ROBOTIS-GIT/ROBOTIS-OP-Series-Data/README.md

# ROBOTIS-OP-Series-Data
ROBOTIS-OP series datas
