ROBOTIS-GIT/ROBOTIS-OP-Series-Data/ROBOTIS-OP, ROBOTIS-OP2/Hardware/Electronics/Sub Controller/DARwIn-OP_Subcontroller_Schematics.pdf

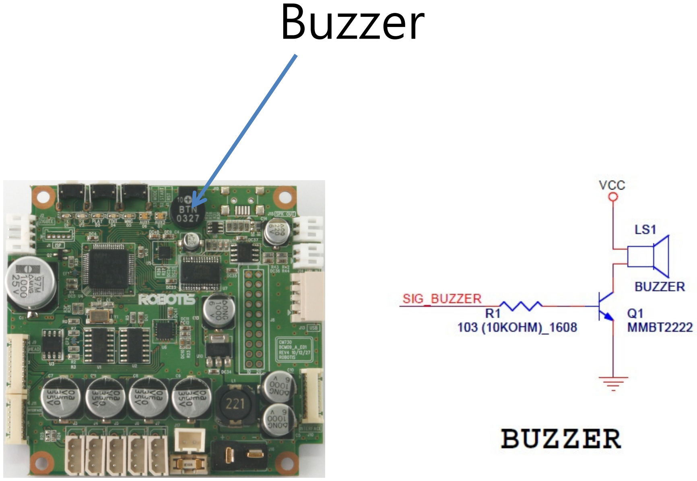
[picture p2: figure]
Buzzer
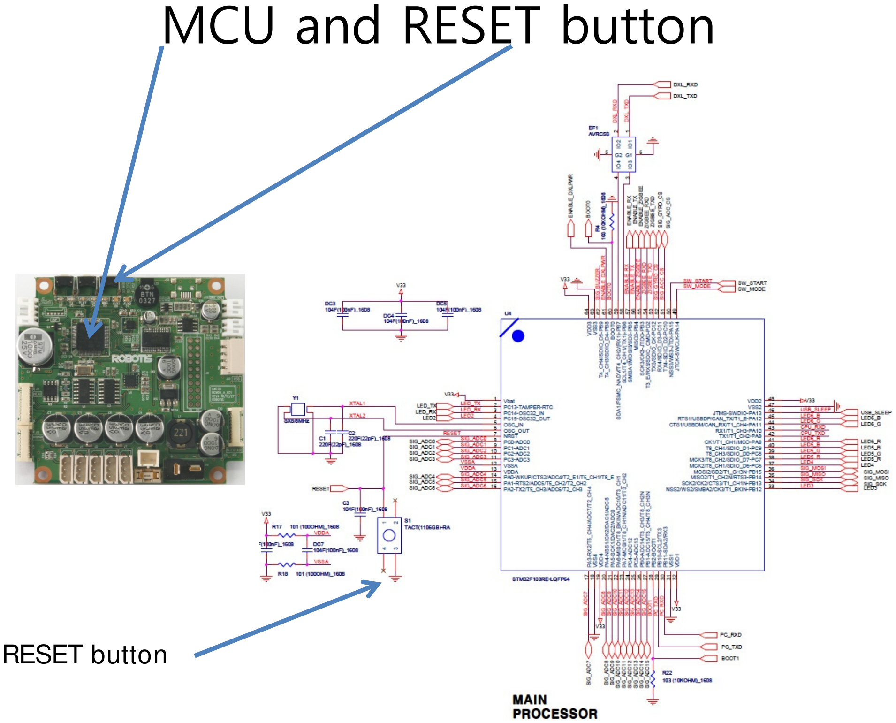
[picture p3: page 2]

MCU and RESET button

RESET button

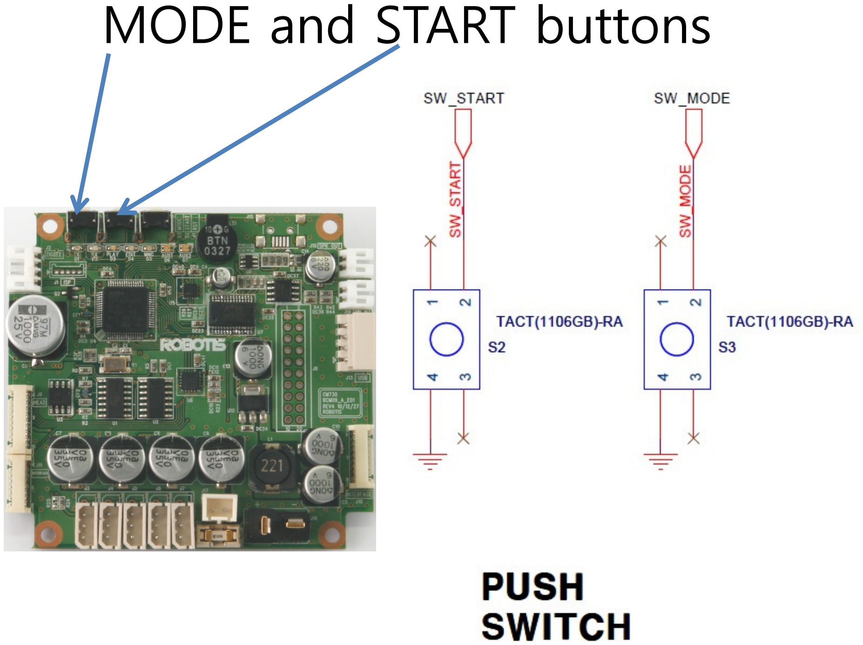
[picture p4: page 3]

MODE and START buttons

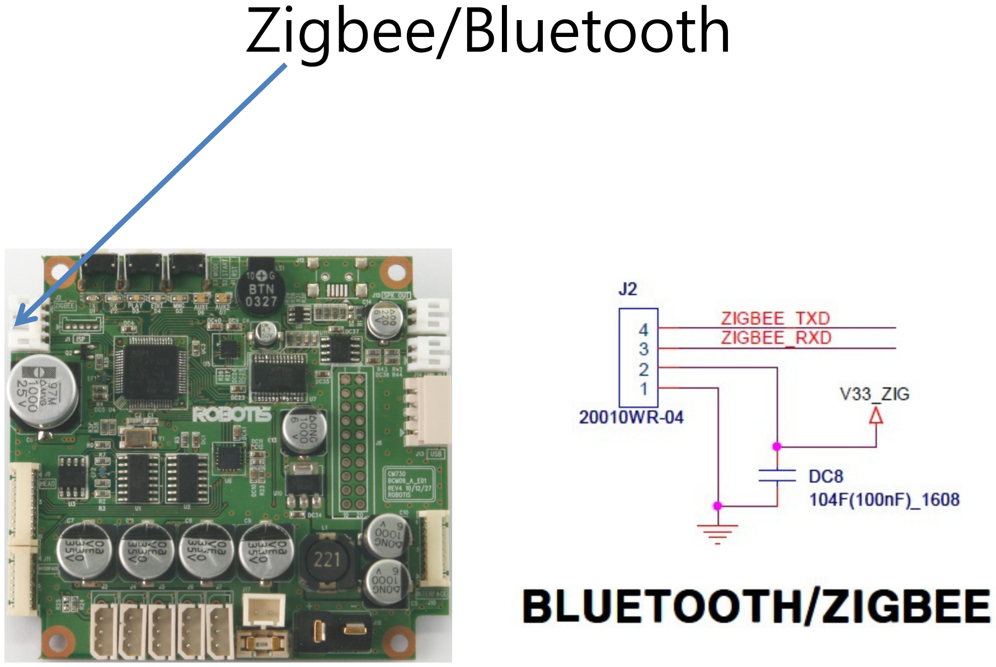
[picture p5: figure]
Zigbee/Bluetooth
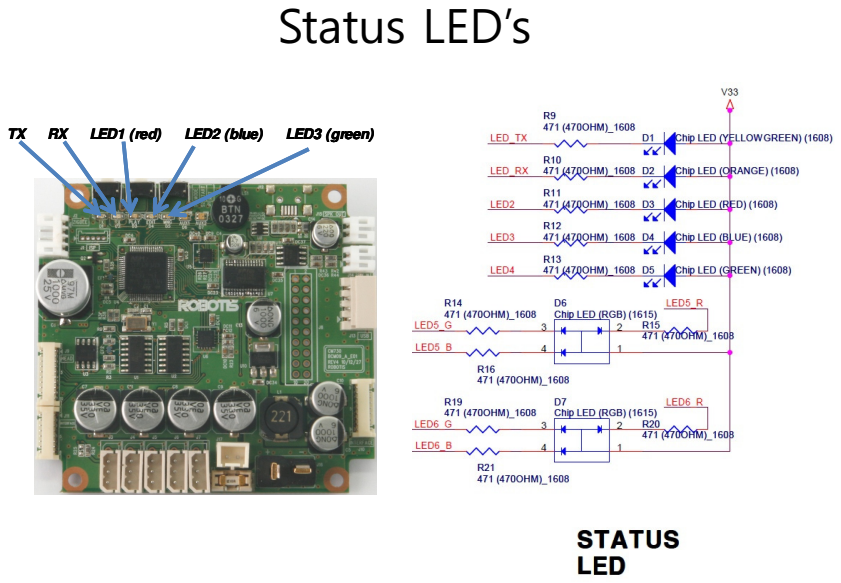
[picture p6: page 5]
Status LED’s; LED1 (red); LED2 (blue); LED3 (green)

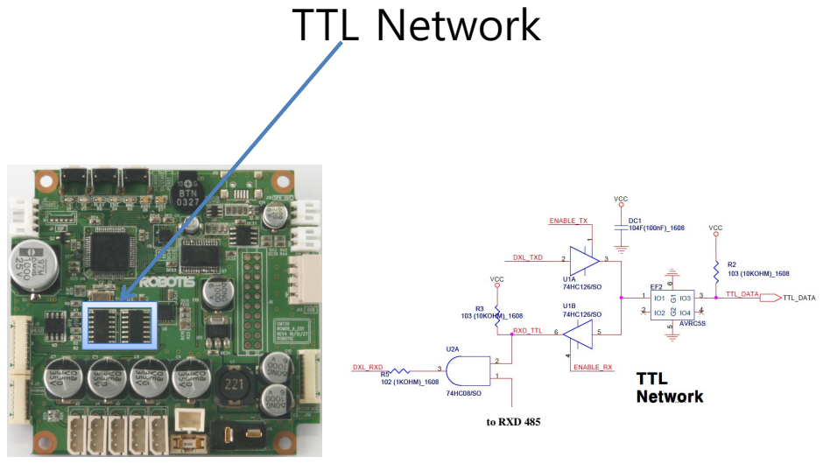
[picture p7: page 6]
TTL Network; to RXD 485

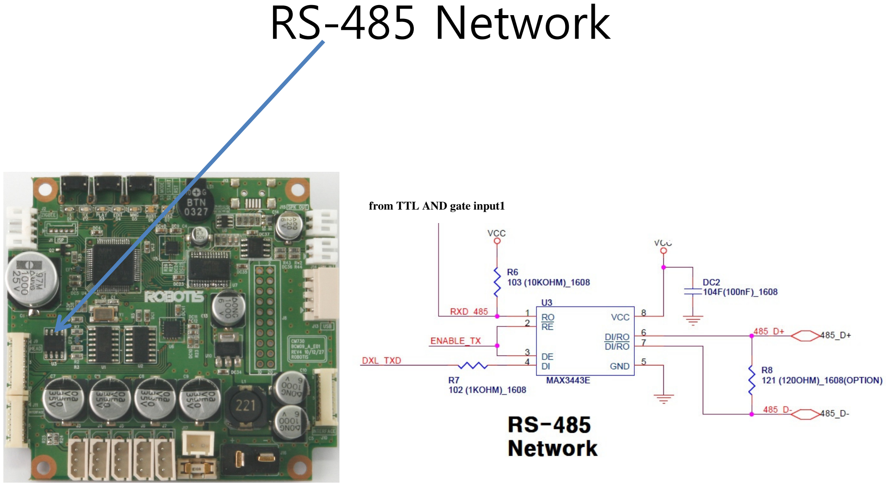
[picture p8: figure]
RS-485 Network; from TTL AND gate input1
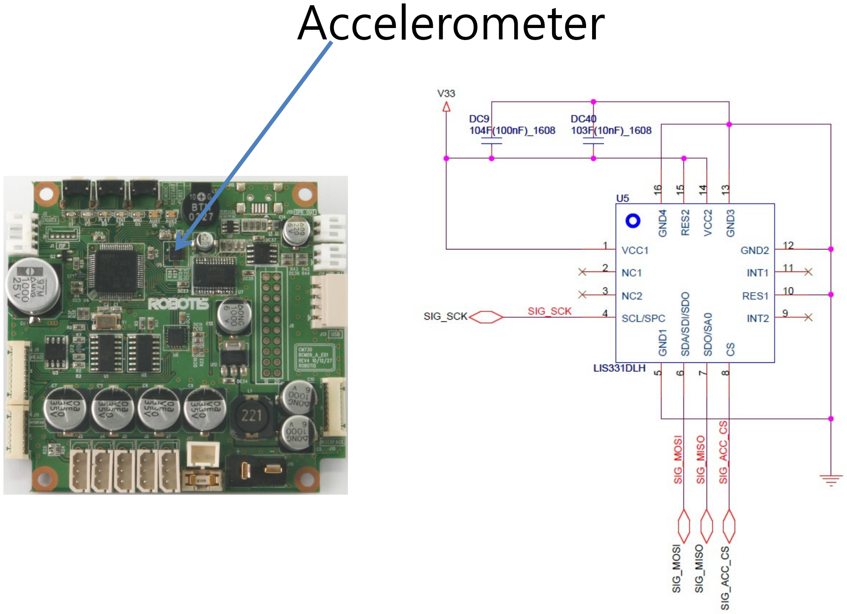
[picture p9: page 8]

Accelerometer

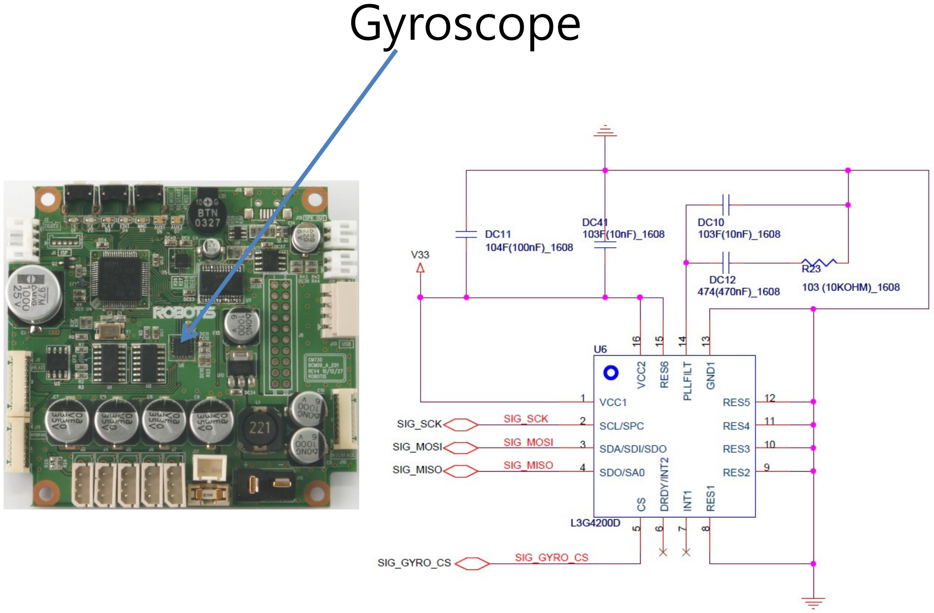
[picture p10: page 9]

Gyroscope

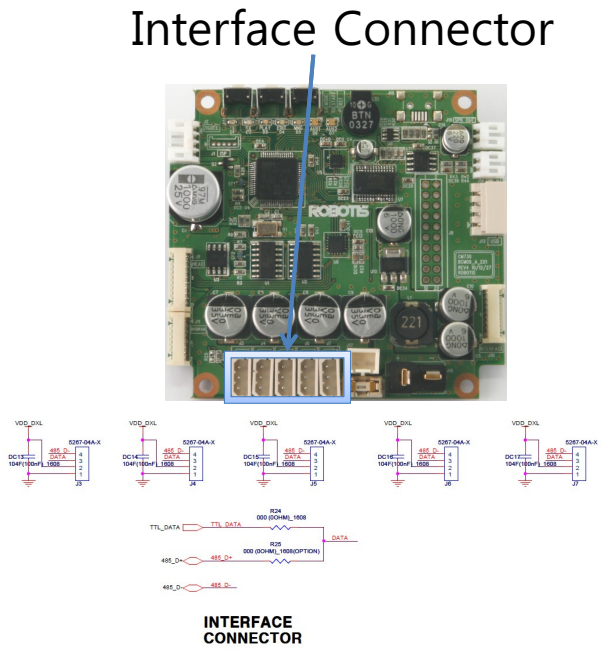
[picture p11: page 10]
Interface Connector

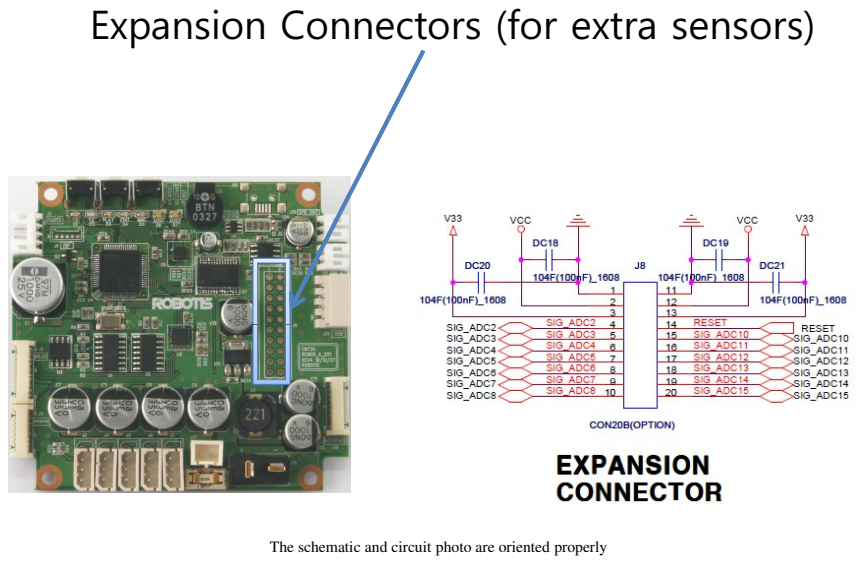
[picture p12: page 11]

Expansion Connectors (for extra sensors)

The schematic and circuit photo are oriented properly

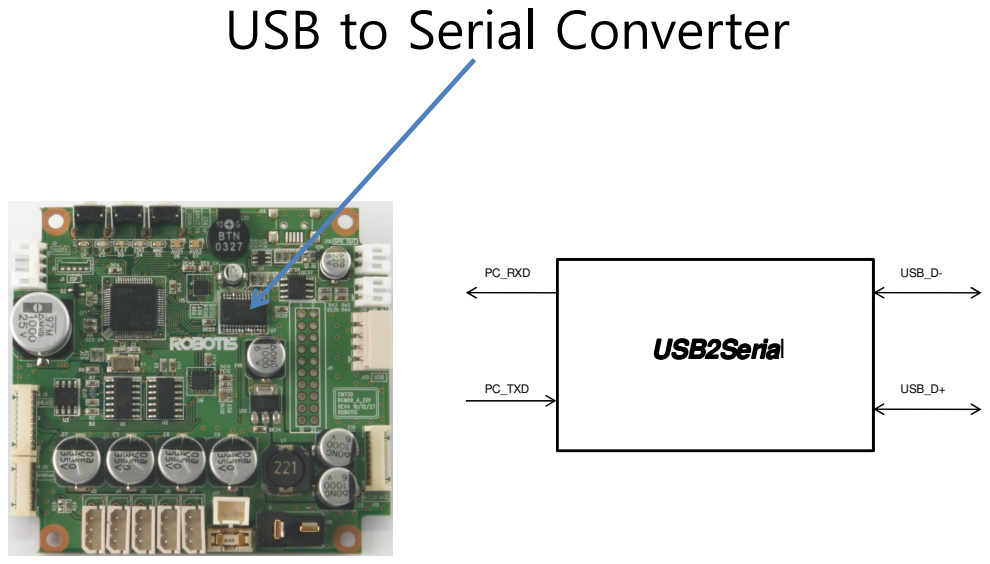
[picture p13: page 12]
USB2Serial; PC_RXD; USB_D-; PC_TXD; USB_D+

USB to Serial Converter

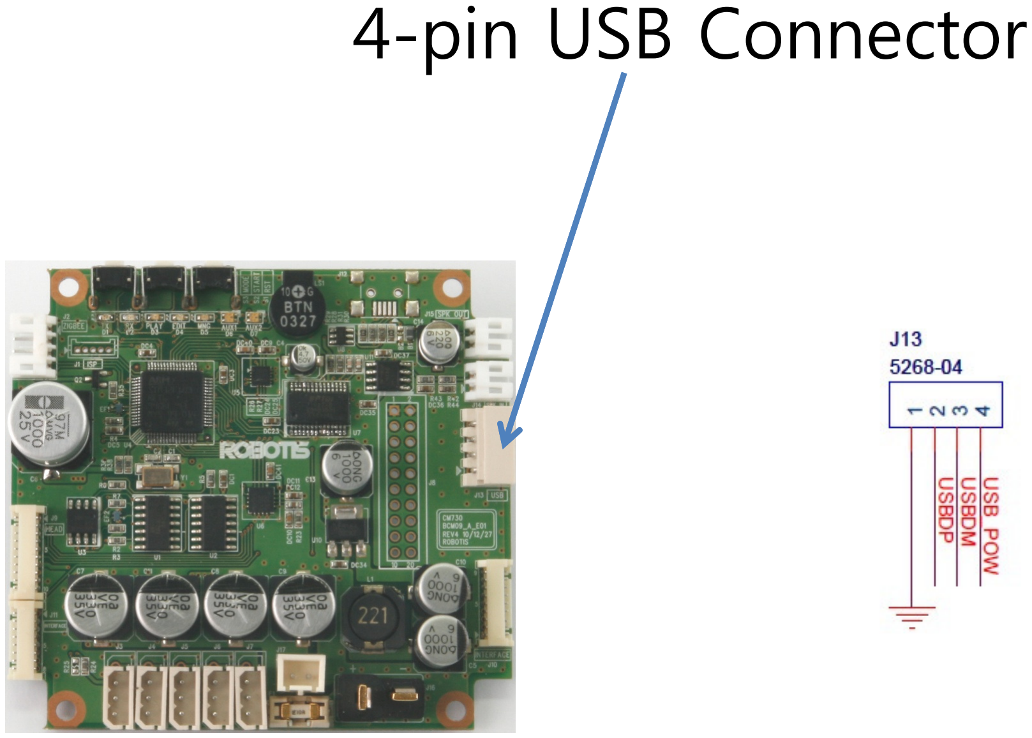
[picture p14: figure]
4-pin USB Connector
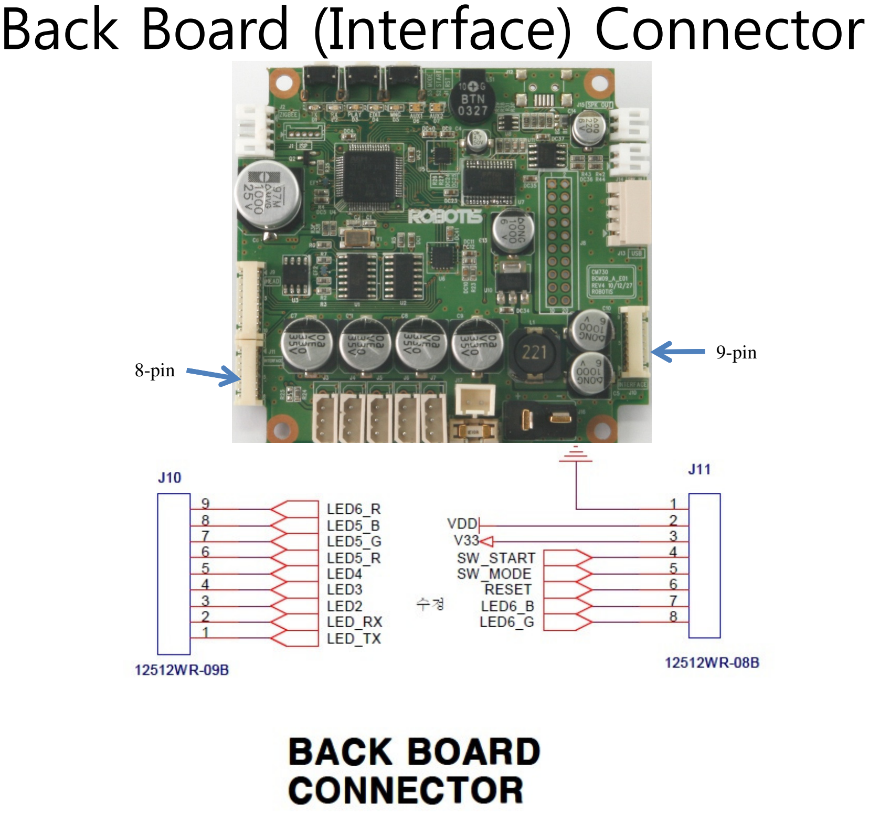
[picture p15: page 14]

Back Board (Interface) Connector

8-pin

9-pin

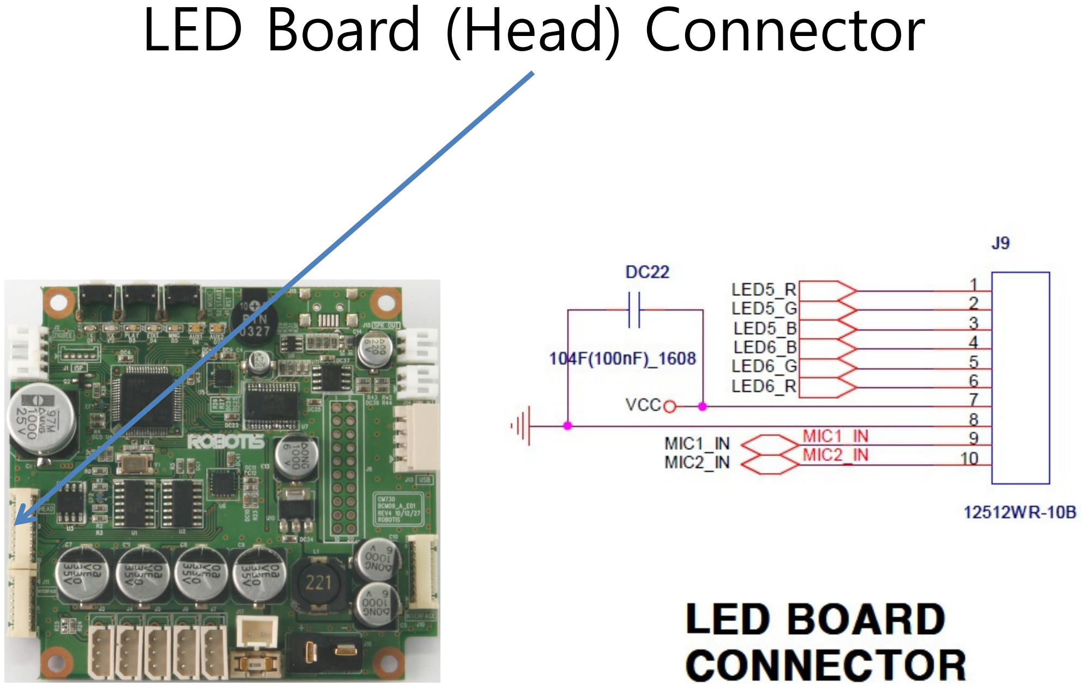
[picture p16: page 15]

LED Board (Head) Connector

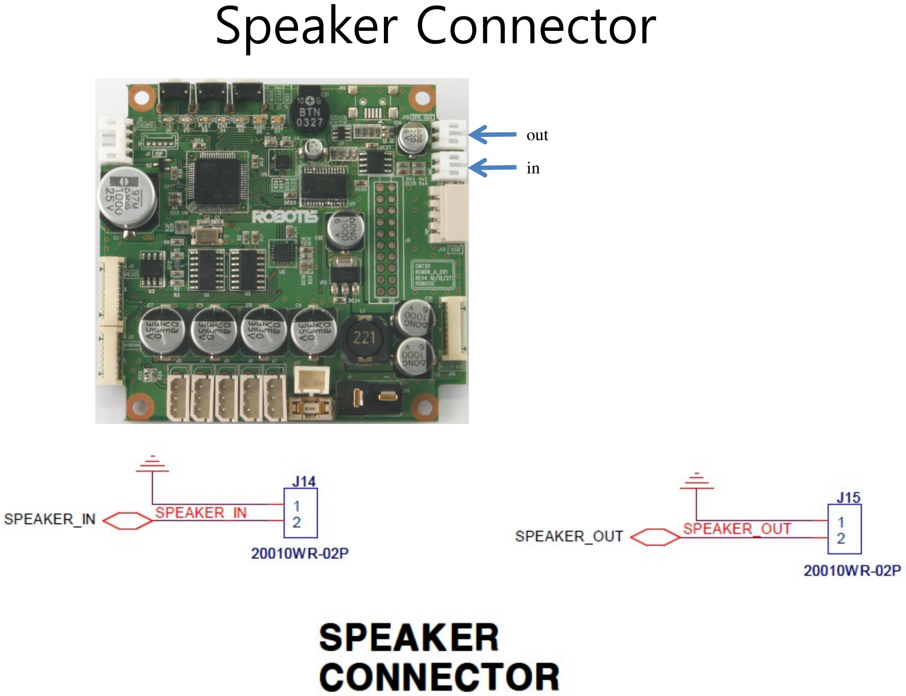
[picture p17: page 16]

Speaker Connector

in

out

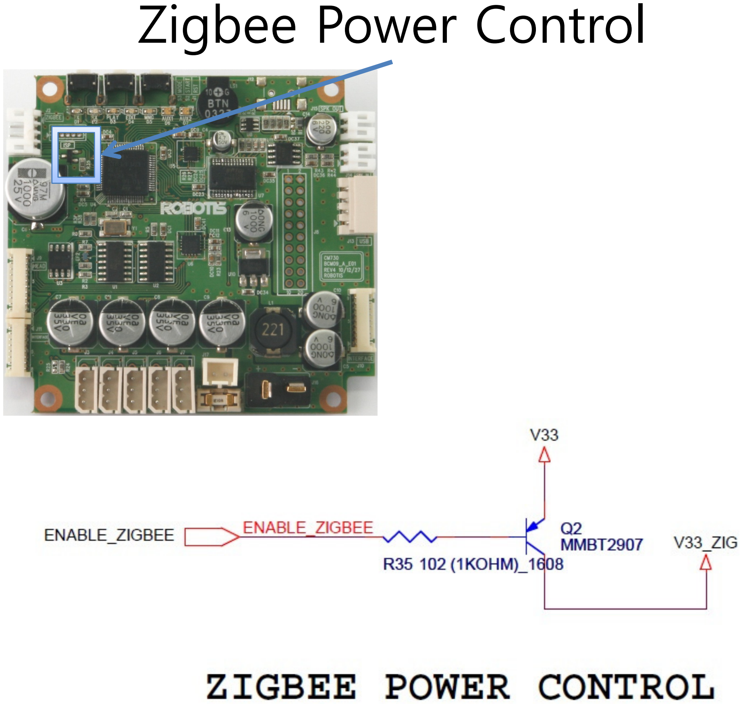
[picture p18: figure]
Zigbee Power Control

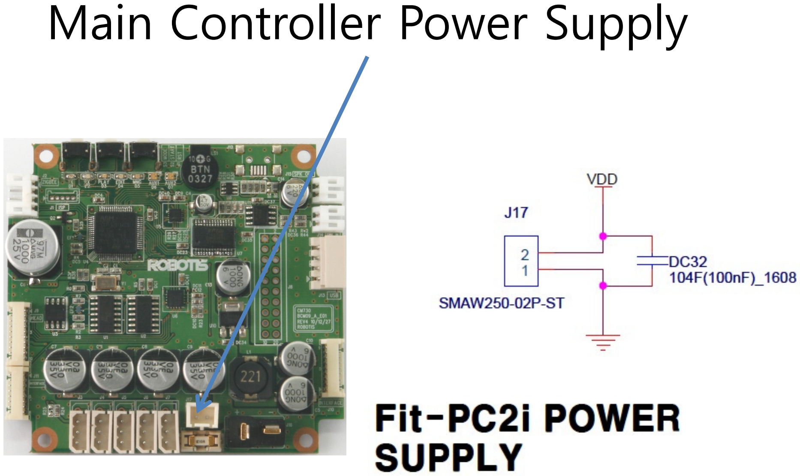
[picture p19: figure]
Main Controller Power Supply

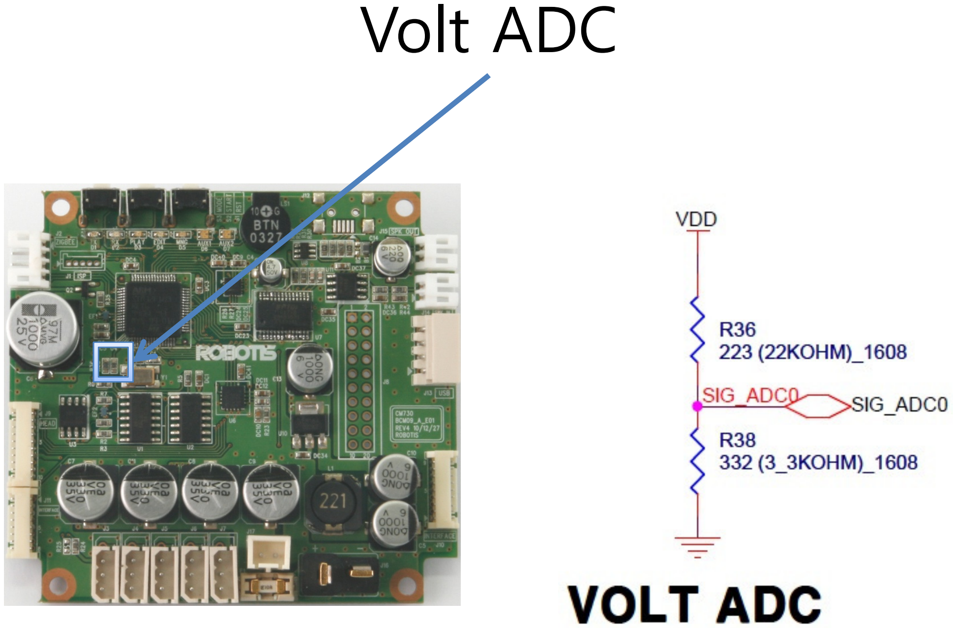
[picture p20: figure]
Volt ADC

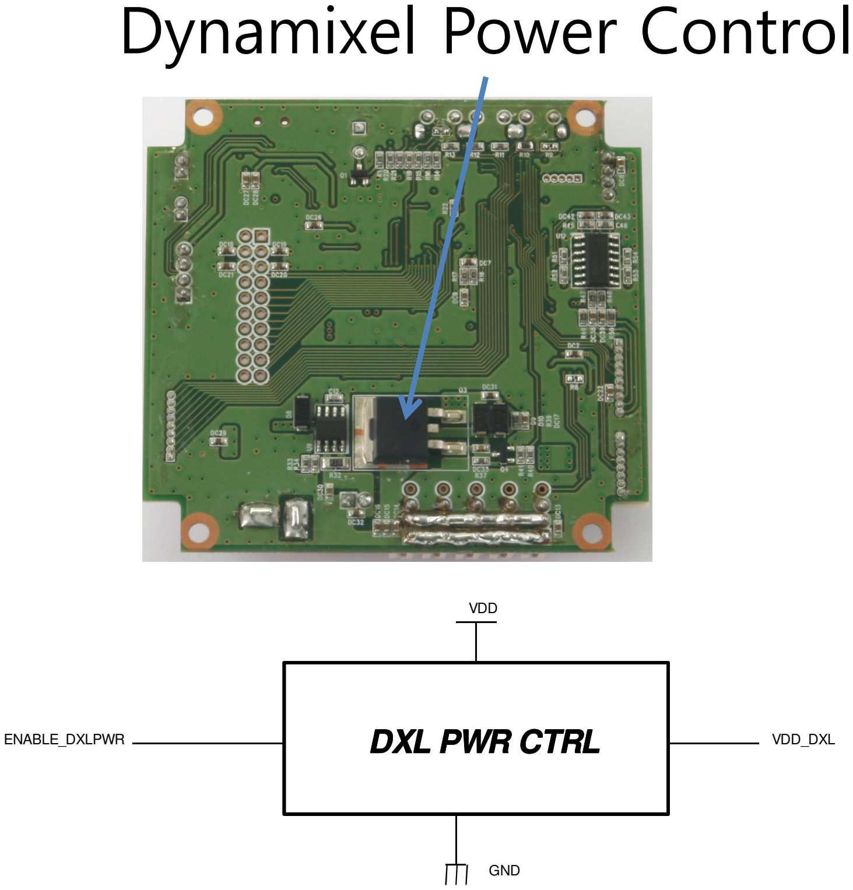
[picture p21: figure]
Dynamixel Power Control; DXL PWR CTRL; VDD; GND; ENABLE_DXLPWR; VDD_DXL

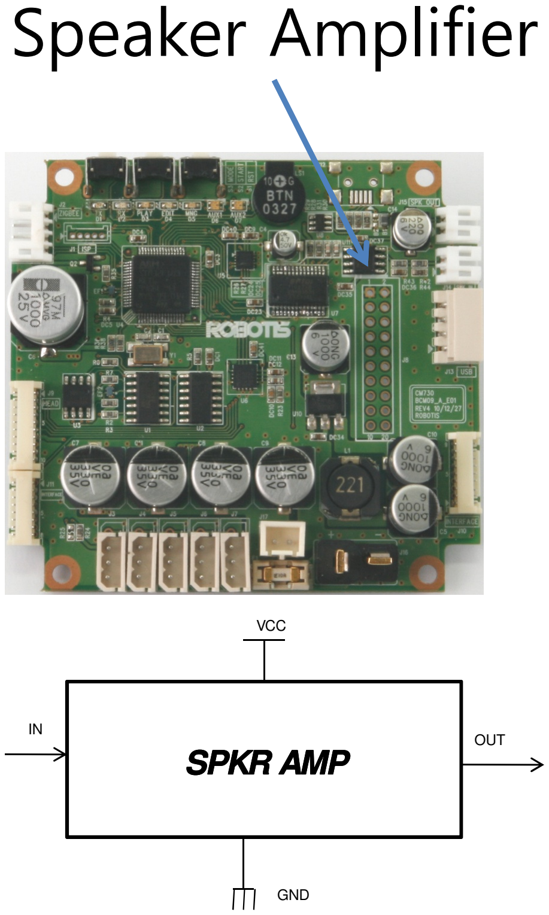
[picture p22: figure]
Speaker Amplifier; SPKR AMP; VCC; GND; OUT
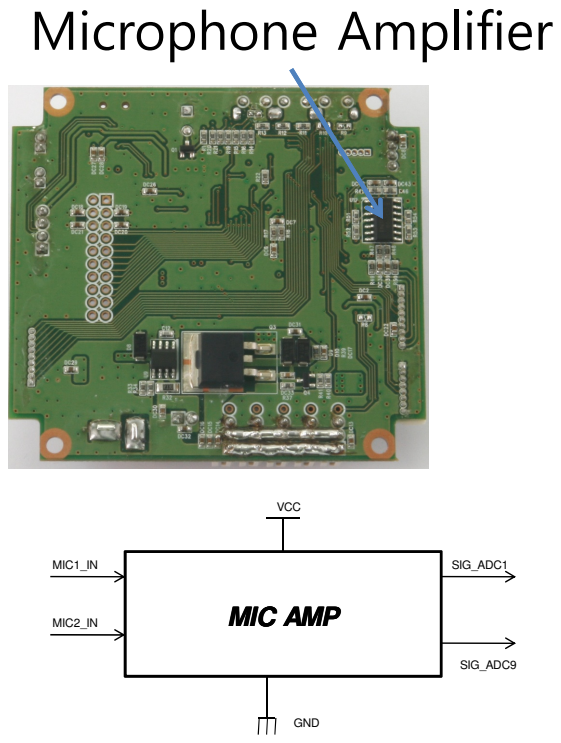
[picture p23: page 22]
Microphone Amplifier; MIC AMP; VCC; GND; MIC1_IN; SIG_ADC9; SIG_ADC1; MIC2_IN
