ROBOTIS-GIT/ROBOTIS-OP-Series-Data/ROBOTIS-OP3/Hardware/Mechanics/Skin/ROBOTIS-OP3-Skin_OP2-Style/README.md

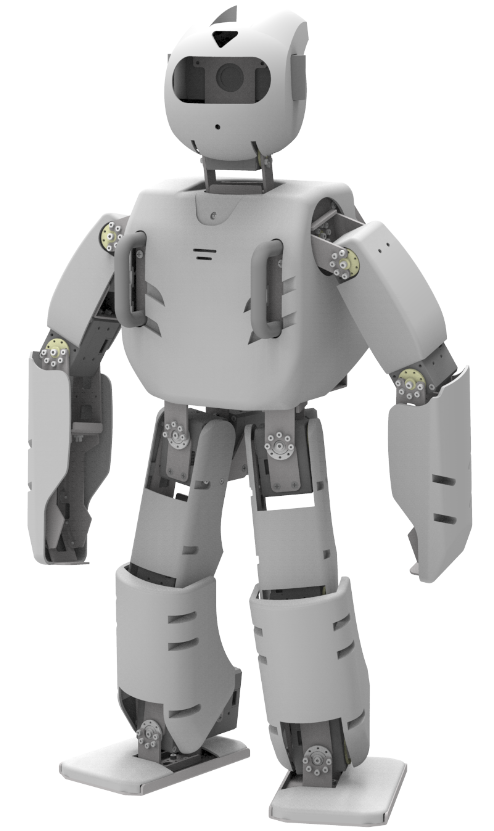
[picture p24: ROBOTIS-OP3/Hardware/Mechanics/Skin/ROBOTIS-OP3-Skin_OP2-Style/ROBOTIS-OP3-Skin_OP2-Style.png]
