ROBOTIS-GIT/ROBOTIS-OP-Series-Data/ROBOTIS-OP3/Hardware/Mechanics/Skin/ROBOTIS-OP3-Skin_Ver1/README.md

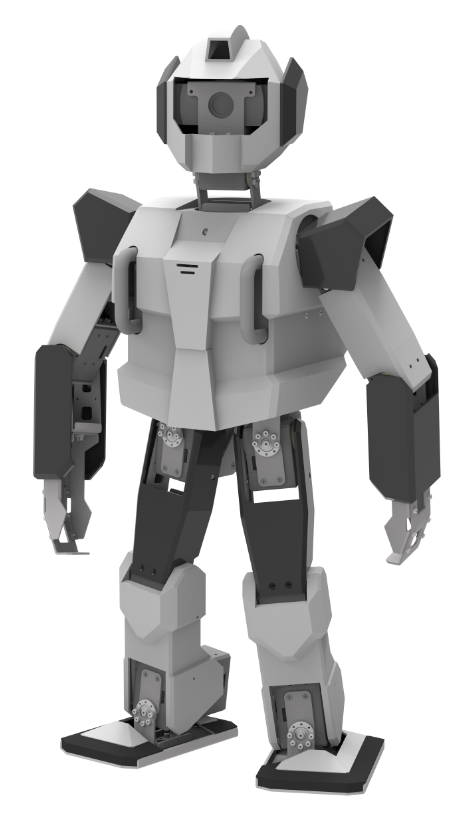
[picture p25: ROBOTIS-OP3/Hardware/Mechanics/Skin/ROBOTIS-OP3-Skin_Ver1/ROBOTIS_OP3-Skin_Ver1.png]
