ROBOTIS-GIT/ROBOTIS-OP-Series-Data/ROBOTIS-OP3/Hardware/Mechanics/Skin/ROBOTIS-OP3-Skin_THORMANG3-Style/README.md

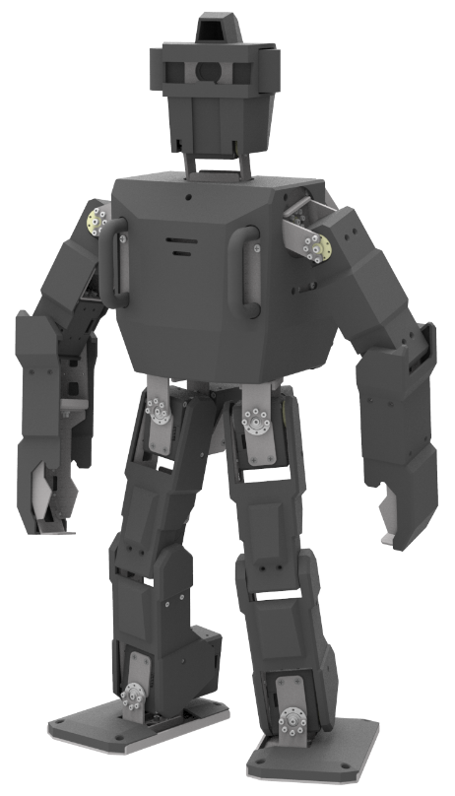
[picture p26: ROBOTIS-OP3/Hardware/Mechanics/Skin/ROBOTIS-OP3-Skin_THORMANG3-Style/ROBOTIS-OP3-Skin_THORMANG3-Style.png]
