ROBOTIS-GIT/ROBOTIS-OP-Series-Data/ROBOTIS-OP, ROBOTIS-OP2/Hardware/Mechanics/DARwIn-OP_Actuator ID.pdf

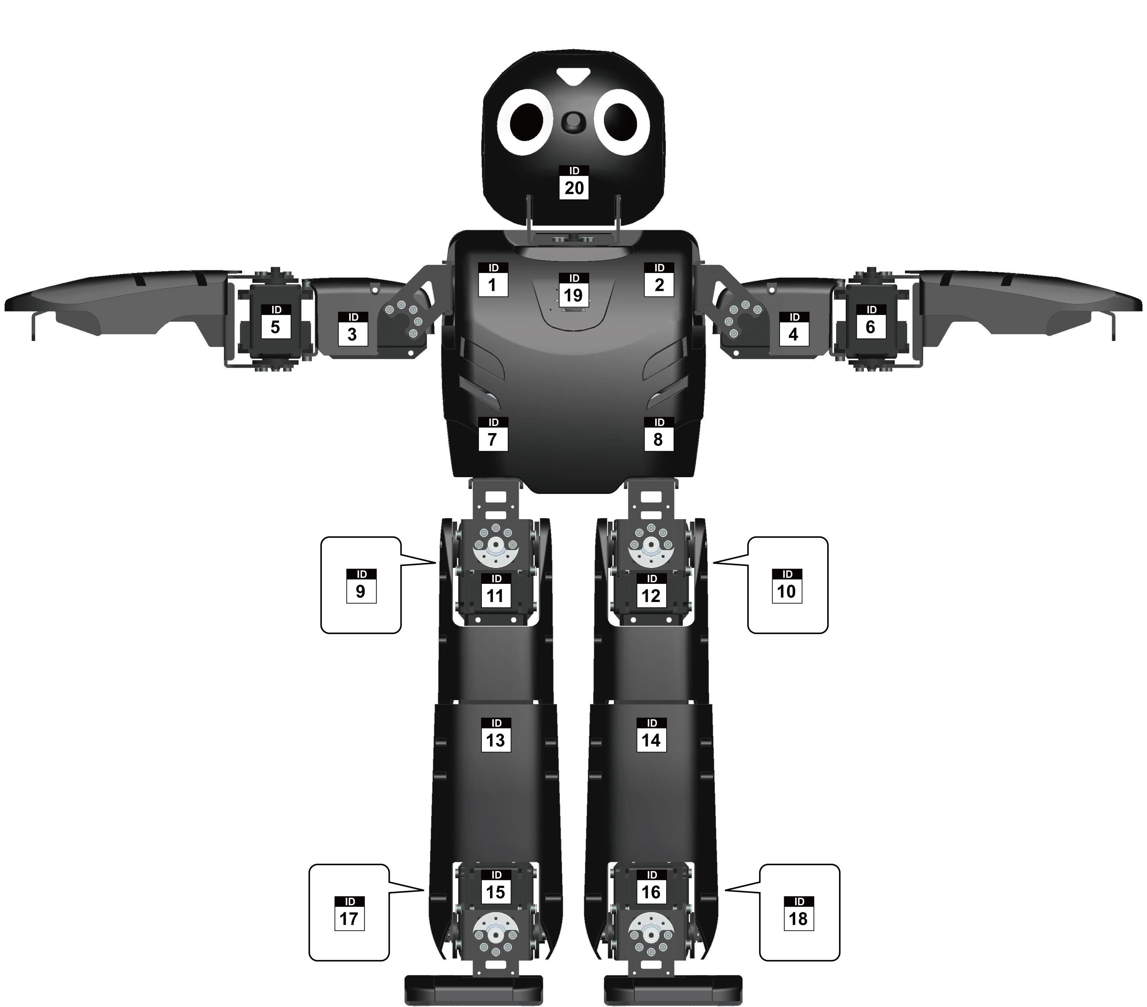
[picture p27: figure]
