ROBOTIS-GIT/ROBOTIS-OP-Series-Data/ROBOTIS-OP, ROBOTIS-OP2/Hardware/Mechanics/DARwIn-OP_Dimension.pdf

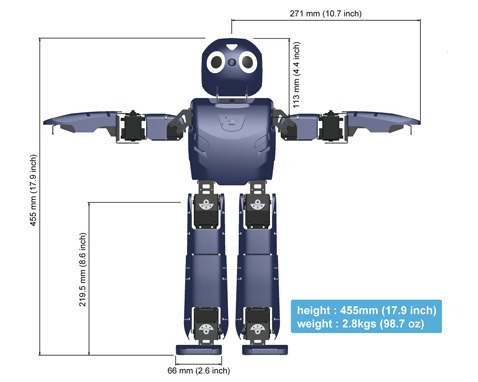
[picture p28: figure]
