ROBOTIS-GIT/ROBOTIS-OP-Series-Data/ROBOTIS-OP, ROBOTIS-OP2/Hardware/Mechanics/DARwIn-OP_Kinematics.pdf

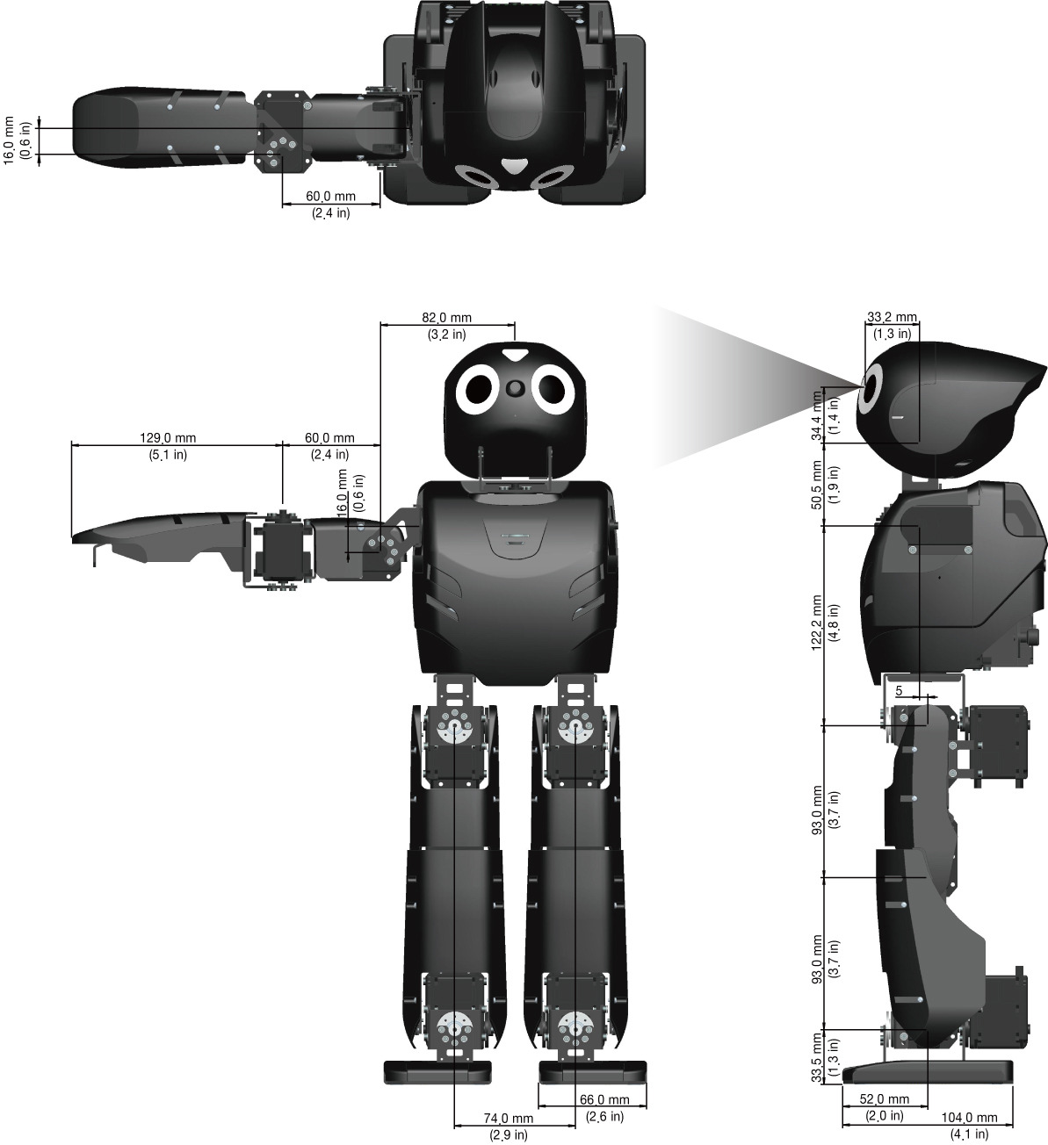
[picture p29: page 1]
