ROBOTIS-GIT/ROBOTIS-OP-Series-Data/ROBOTIS-OP, ROBOTIS-OP2/Overall/DARwIn-OP_Brochure Page1-Page4.pdf

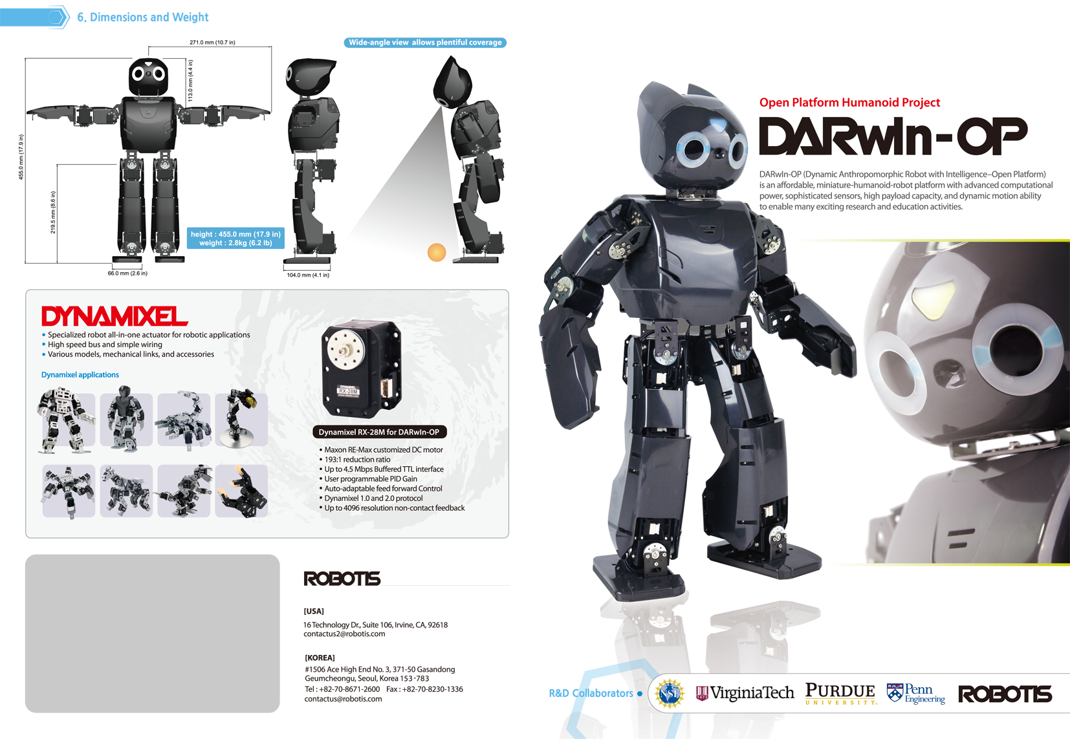
[picture p30: page 1]
