ROBOTIS-GIT/ROBOTIS-OP-Series-Data/ROBOTIS-OP, ROBOTIS-OP2/Overall/DARwIn-OP_Brochure Page2-Page3.pdf

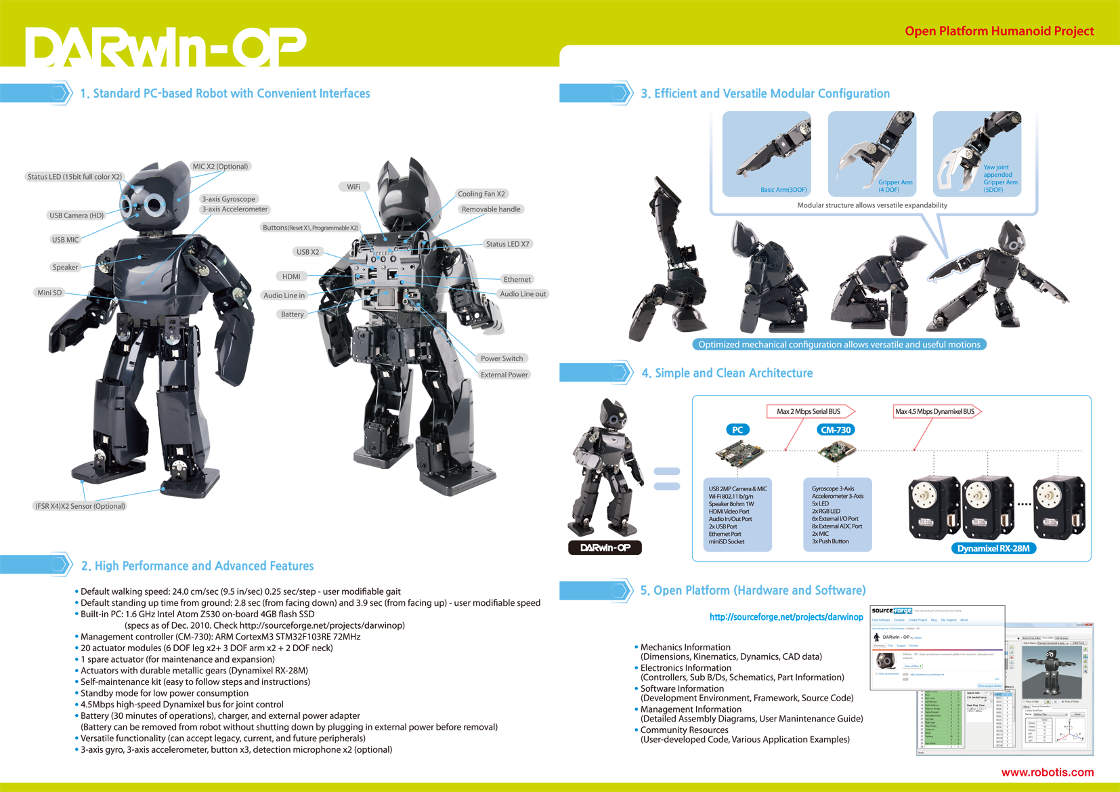
[picture p31: page 1]
