ROBOTIS-GIT/ROBOTIS-OP-Series-Data/ROBOTIS-OP3/Hardware/Mechanics/Skin/ROBOTIS-OP3_cvr_thigh_prt.stp

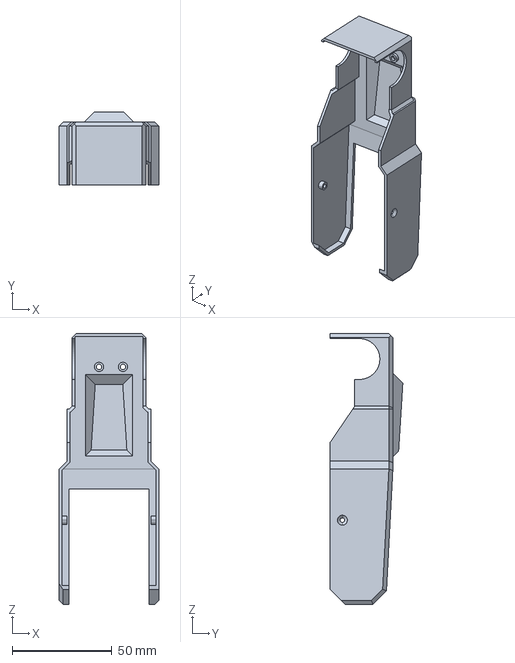
[picture p32: CAD file, 2017-07-24, last stored version]
ROBOTIS-OP3/Hardware/Mechanics/Skin/ROBOTIS-OP3_cvr_thigh_prt.stp
50.0 x 36.5 x 136.0 mm
