ROBOTIS-GIT/ROBOTIS-OP-Series-Data/ROBOTIS-OP3/Hardware/Mechanics/Skin/ROBOTIS-OP3_cvr_arm_l_prt.stp

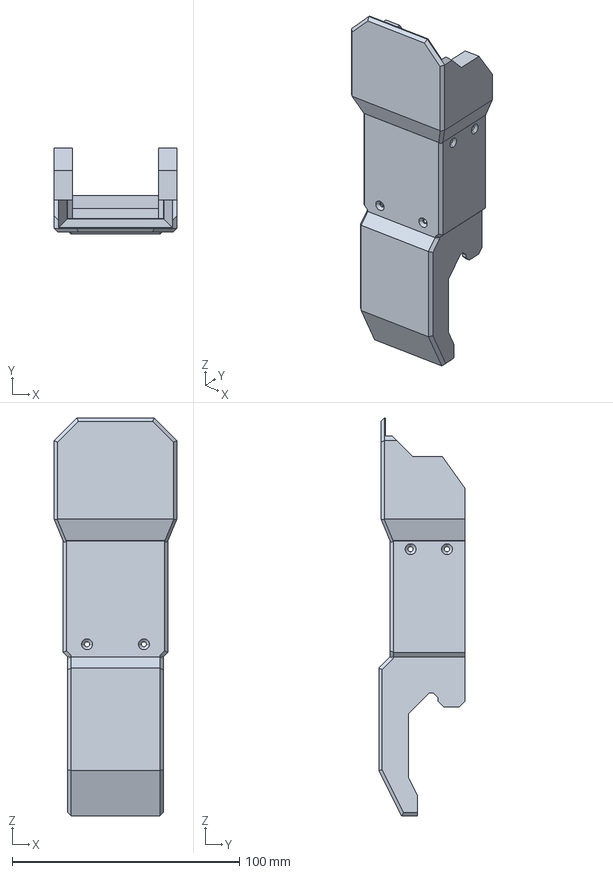
[picture p33: CAD file, 2017-07-24, last stored version]
ROBOTIS-OP3/Hardware/Mechanics/Skin/ROBOTIS-OP3_cvr_arm_l_prt.stp
54.0 x 38.0 x 175.0 mm
