ROBOTIS-GIT/ROBOTIS-OP-Series-Data/ROBOTIS-OP3/Hardware/Mechanics/Skin/ROBOTIS-OP3_cvr_foot_prt.stp

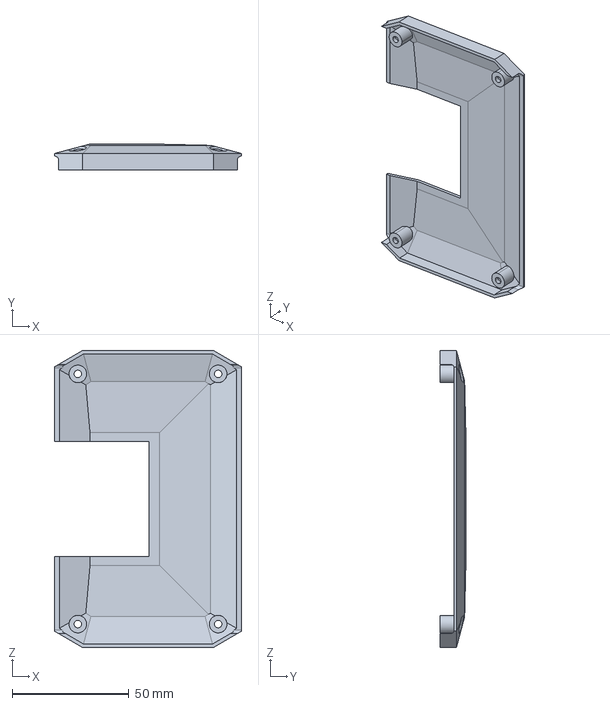
[picture p34: CAD file, 2017-07-24, last stored version]
ROBOTIS-OP3/Hardware/Mechanics/Skin/ROBOTIS-OP3_cvr_foot_prt.stp
80.0 x 11.0 x 127.0 mm
