ROBOTIS-GIT/ROBOTIS-OP-Series-Data/ROBOTIS-OP3/Hardware/Mechanics/Skin/ROBOTIS-OP3_cvr_tibia_prt.stp

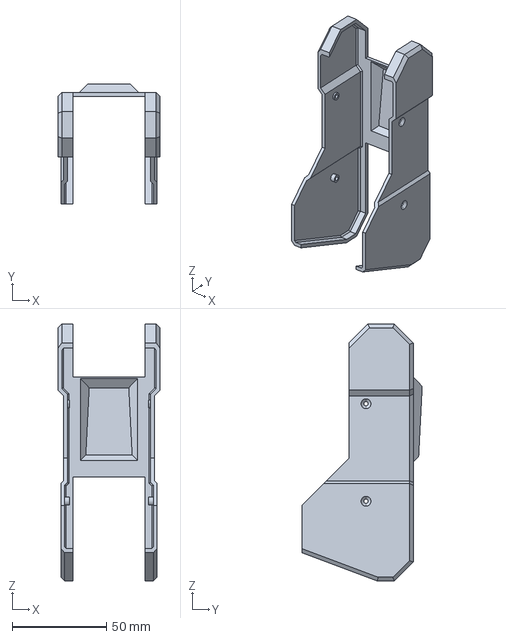
[picture p35: CAD file, 2017-07-24, last stored version]
ROBOTIS-OP3/Hardware/Mechanics/Skin/ROBOTIS-OP3_cvr_tibia_prt.stp
54.0 x 63.7 x 136.0 mm
