ROBOTIS-GIT/ROBOTIS-OP-Series-Data/ROBOTIS-OP3/Hardware/Mechanics/Skin/ROBOTIS-OP3_cvr_body_b_prt.stp

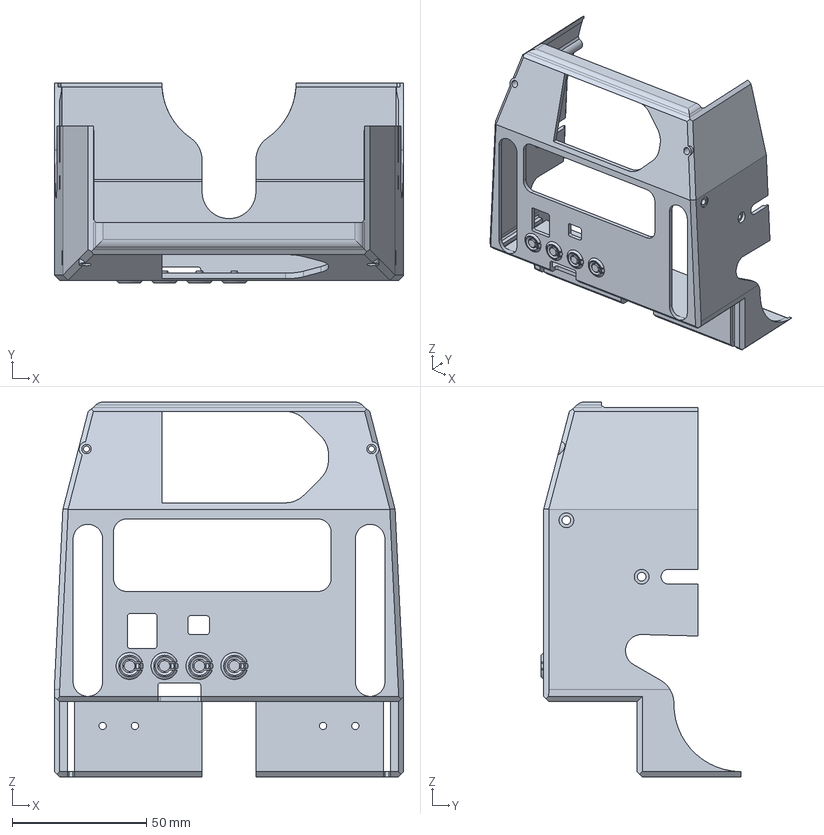
[picture p36: CAD file, 2017-07-24, last stored version]
ROBOTIS-OP3/Hardware/Mechanics/Skin/ROBOTIS-OP3_cvr_body_b_prt.stp
130.0 x 74.5 x 139.5 mm
