ROBOTIS-GIT/ROBOTIS-OP-Series-Data/ROBOTIS-OP, ROBOTIS-OP2/Hardware/Mechanics/DARwIn OP Wiring Manual.pdf

# DARwIn OP Wiring Manual

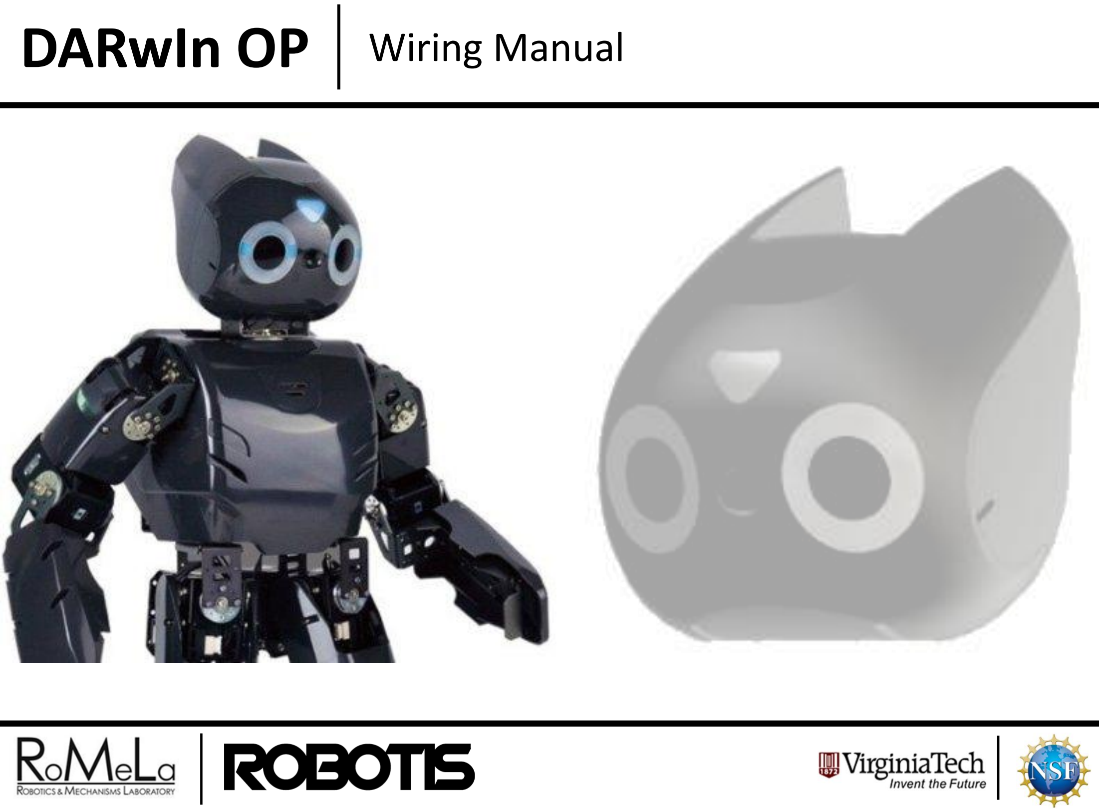
[picture p119: page 1]

Principal authors:

Thanh Pham
Stephen Rouleau
Coleman Knabe
Matthew Stanford
Nolawe Woldesemayat
Mark Umansky
Justin Siegal
Austin Kim
Allison McCormack
Dante Branch
Viktor Orekhov

PERMISSION IS GRANTED TO COPY, DISTRIBUTE AND/OR MODIFY THIS DOCUMENT UNDER THE TERMS OF THE CREATIVE COMMONS ATTRIBUTION-NONCOMMERCIAL-SHAREALIKE
3.0 | UNPORTED | LICENSE. | TO | VIEW | A | COPY | OF | THIS | LICENSE, | VISIT
HTTP://CREATIVECOMMONS.ORG/LICENSES/BY-NC-SA/3.0/

## DARwIn OP Wiring Manual

Created by RoMeLa at Virginia Tech

Version: | 1.0.1
Created: | 5/3/2011
Modified: | 7/26/2011
THIS | WIRING | MANUAL | IS | TO | BE | USED | IN
CONJUNCTION WITH THE FOLLOWING DOCUMENTS:

### DARwIn OP Assembly Manual DARwIn OP Fabrication Manual

# DARwIn OP Wiring Manual

Table of contents

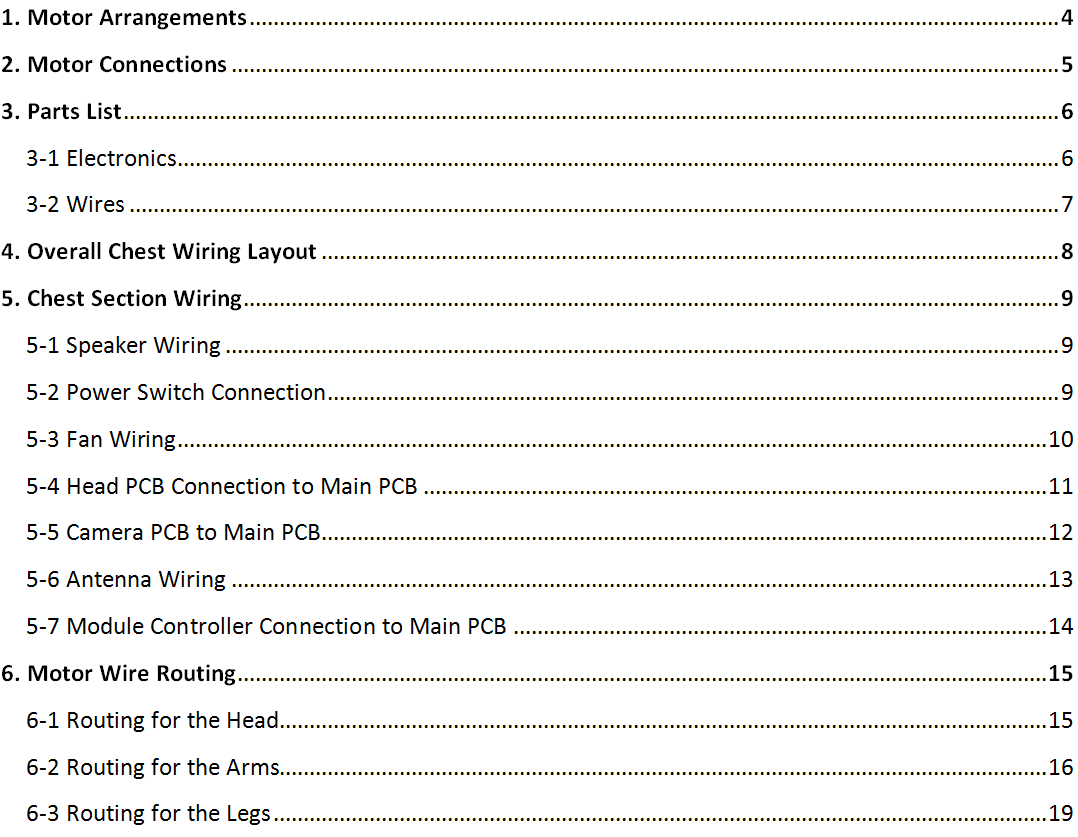
[picture p120: figure]

# 1. Motor Arrangements

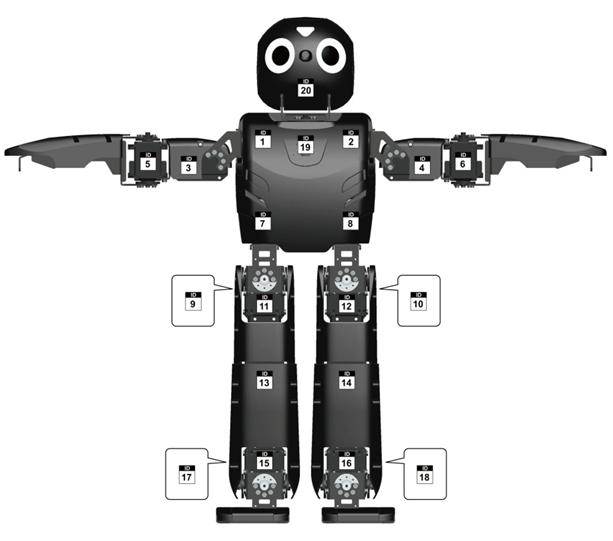
[picture p121: figure]

Actuator ID | Actuator Type
M1 | Dynamixel MX-28
M2 | Dynamixel MX-28
M3 | Dynamixel MX-28
M4 | Dynamixel MX-28
M5 | Dynamixel MX-28
M6 | Dynamixel MX-28
M7 | Dynamixel MX-28
M8 | Dynamixel MX-28
M9 | Dynamixel MX-28
M10 | Dynamixel MX-28
M11 | Dynamixel MX-28
M12 | Dynamixel MX-28
M13 | Dynamixel MX-28
M14 | Dynamixel MX-28
M15 | Dynamixel MX-28
M16 | Dynamixel MX-28
M17 | Dynamixel MX-28
M18 | Dynamixel MX-28
M19 | Dynamixel MX-28
M20 | Dynamixel MX-28

# 2. Motor Connections

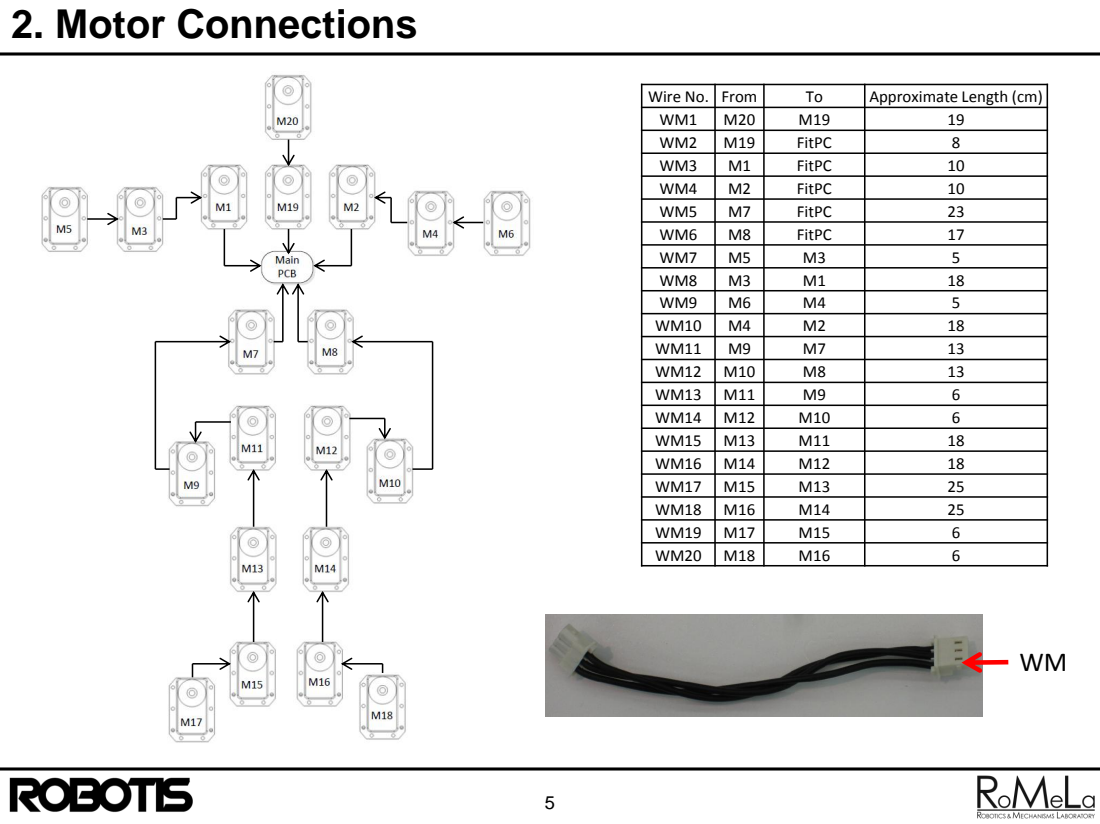
[picture p122: page 5]

Wire No. | From | To | Approximate Length (cm)
WM1 | M20 | M19 | 19
WM2 | M19 | FitPC | 8
WM3 | M1 | FitPC | 10
WM4 | M2 | FitPC | 10
WM5 | M7 | FitPC | 23
WM6 | M8 | FitPC | 17
WM7 | M5 | M3 | 5
WM8 | M3 | M1 | 18
WM9 | M6 | M4 | 5
WM10 | M4 | M2 | 18
WM11 | M9 | M7 | 13
WM12 | M10 | M8 | 13
WM13 | M11 | M9 | 6
WM14 | M12 | M10 | 6
WM15 | M13 | M11 | 18
WM16 | M14 | M12 | 18
WM17 | M15 | M13 | 25
WM18 | M16 | M14 | 25
WM19 | M17 | M15 | 6
WM20 | M18 | M16 | 6

# 3-1. Parts List 1 - Electronics

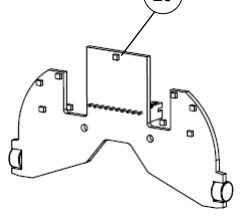
[picture p123: figure]

Part Number | Description | Qty.
19 | Camera | 1
20 | Head PCB | 1
22 | FitPC | 1
23 | CM730 | 1
24 | Antenna | 1
25 | Antenna Connector | 1
26 | Fan | 2
27 | Back Cover PCB | 1
19 | 20

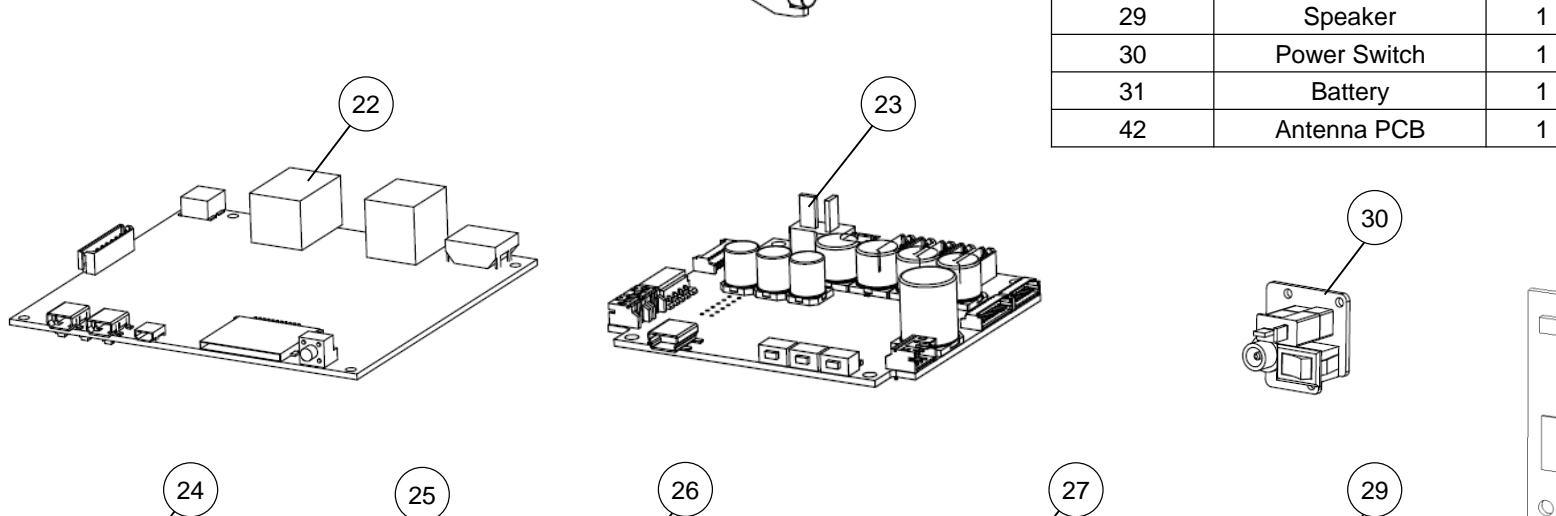
[picture p124: figure]
Speaker; Power Switch; Battery; Antenna PCB

42

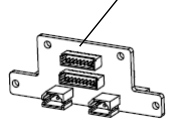
[picture p125: figure]

# 3-2. Parts List 2 - Wires

Wire No. | Wire Name | Approximate Length (cm)
W1 | Fan Wire | 5
W2 | Fan PCB Wire 8-pin | 18
W3 | Fan PCB Wire 9-pin | 18
W4 | Power Switch Wire | 13
W5 | Speaker Wire | 13
W6 | Speaker Extension Wire | 9
W7 | Antenna Wire | 10
W8 | Antenna PCB Wire | 5
W9 | FitPC 3-Way Wire | 5
W10 | CM730 to FitPC-Top Wire | 11
W11 | CM730 to FitPC-Bottom Wire | 13
W12 | Head PCB Wire 10-pin | 28
W13 | Camera PCB Wire | 23

# 4. Overall Chest Wiring Layout

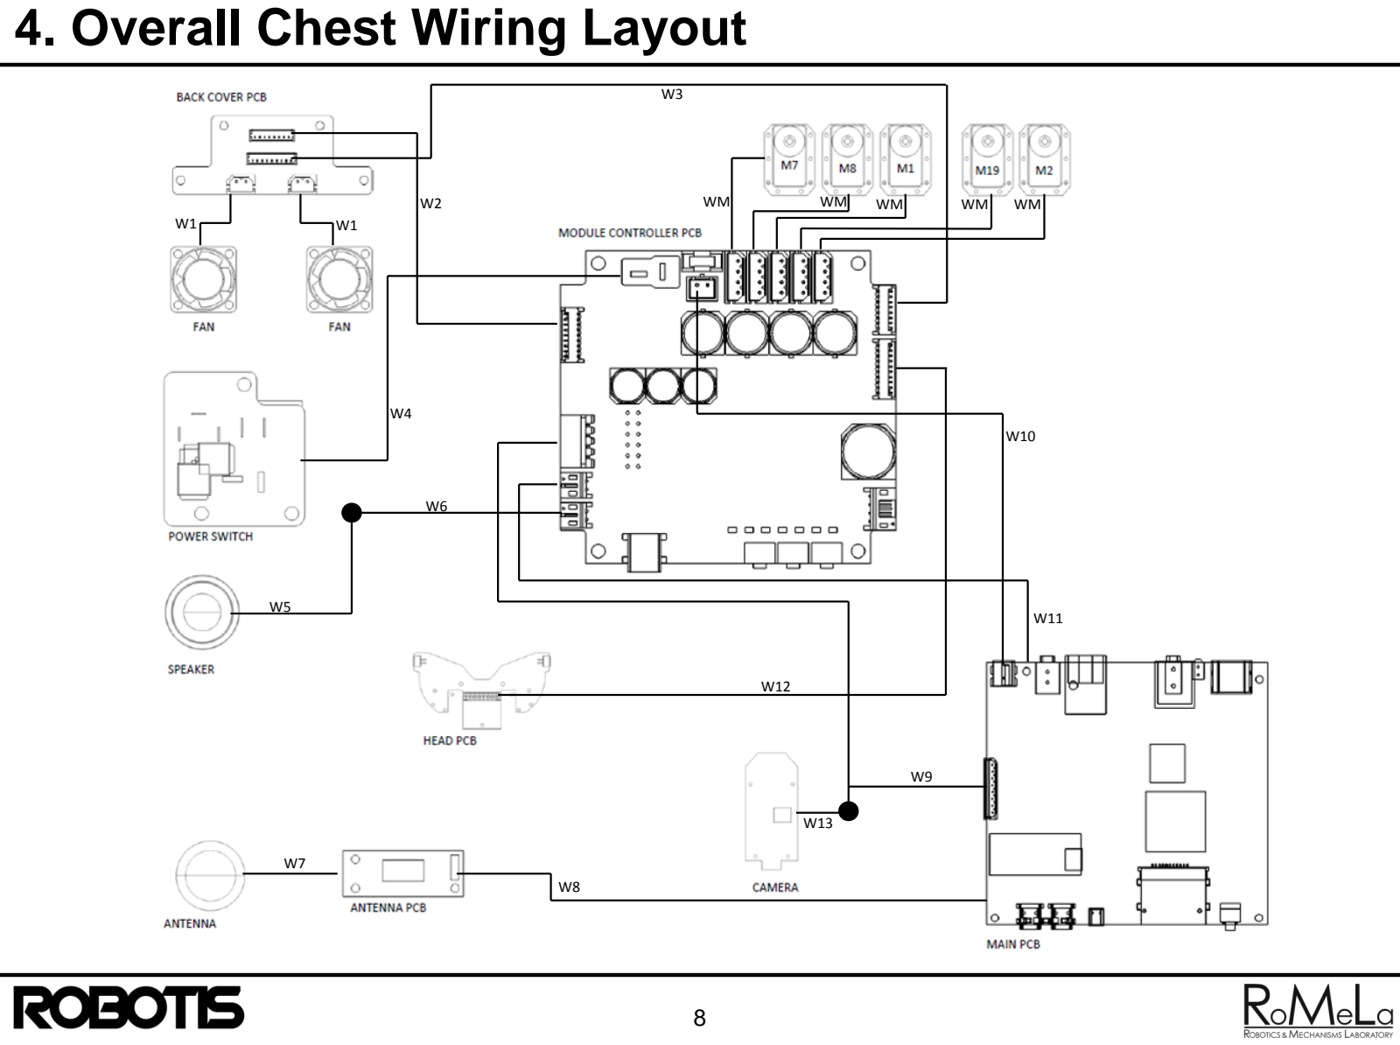
[picture p126: page 8]

W1 | W1

W2

W3

WM | WM | WM | WM | WM

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
# 5. Chest Section Wiring

W6

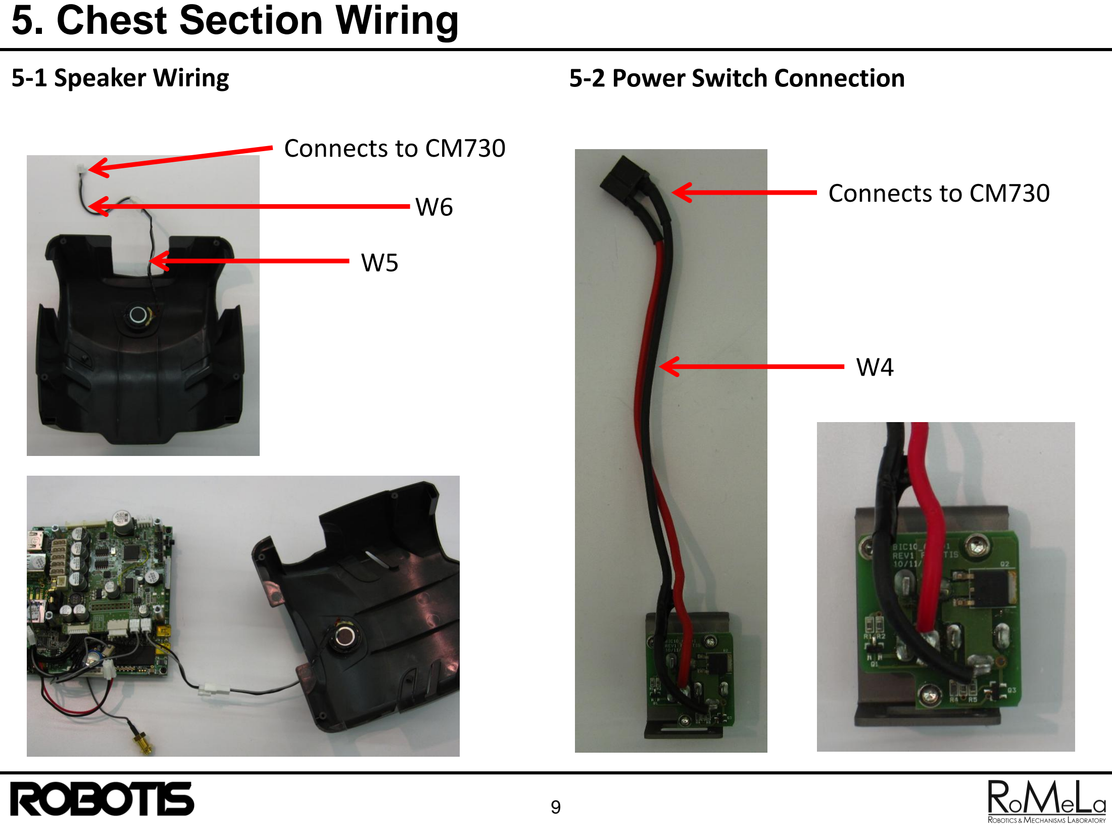
[picture p127: page 9]

W5

W4

5-1 Speaker Wiring | 5-2 Power Switch Connection

## Connects to CM730

## Connects to CM730

# 5. Chest Section Wiring

## 5-3 Fan Wiring

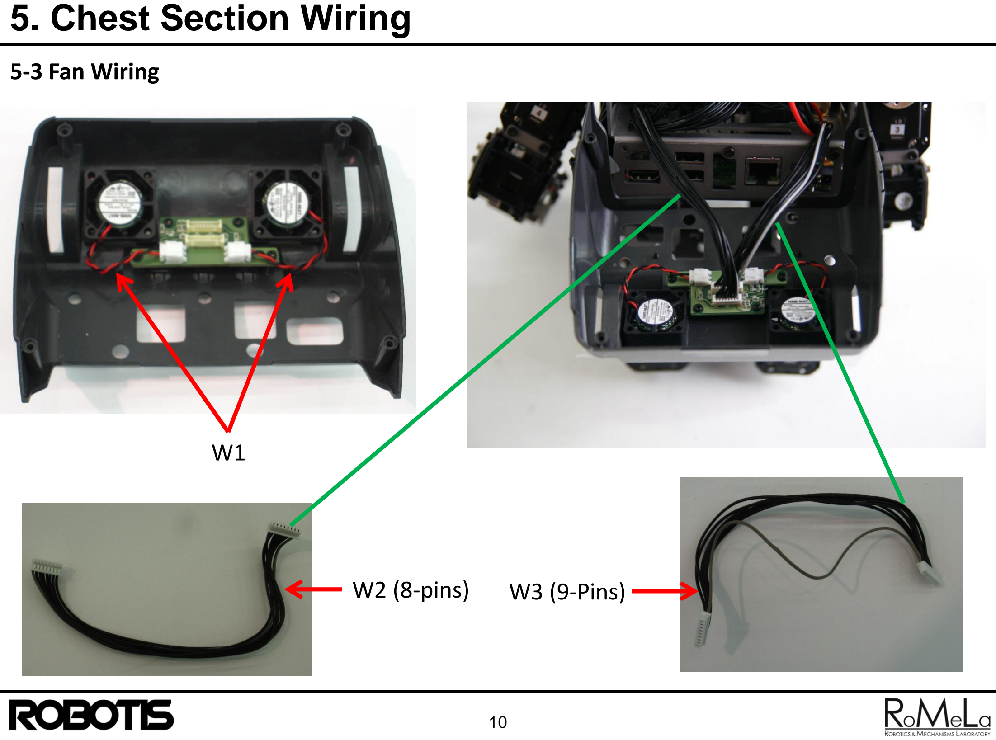
[picture p128: page 10]

W1

## W2 (8-pins) W3 (9-Pins)

# 5. Chest Section Wiring

## 5-4 Head PCB Connection to CM730

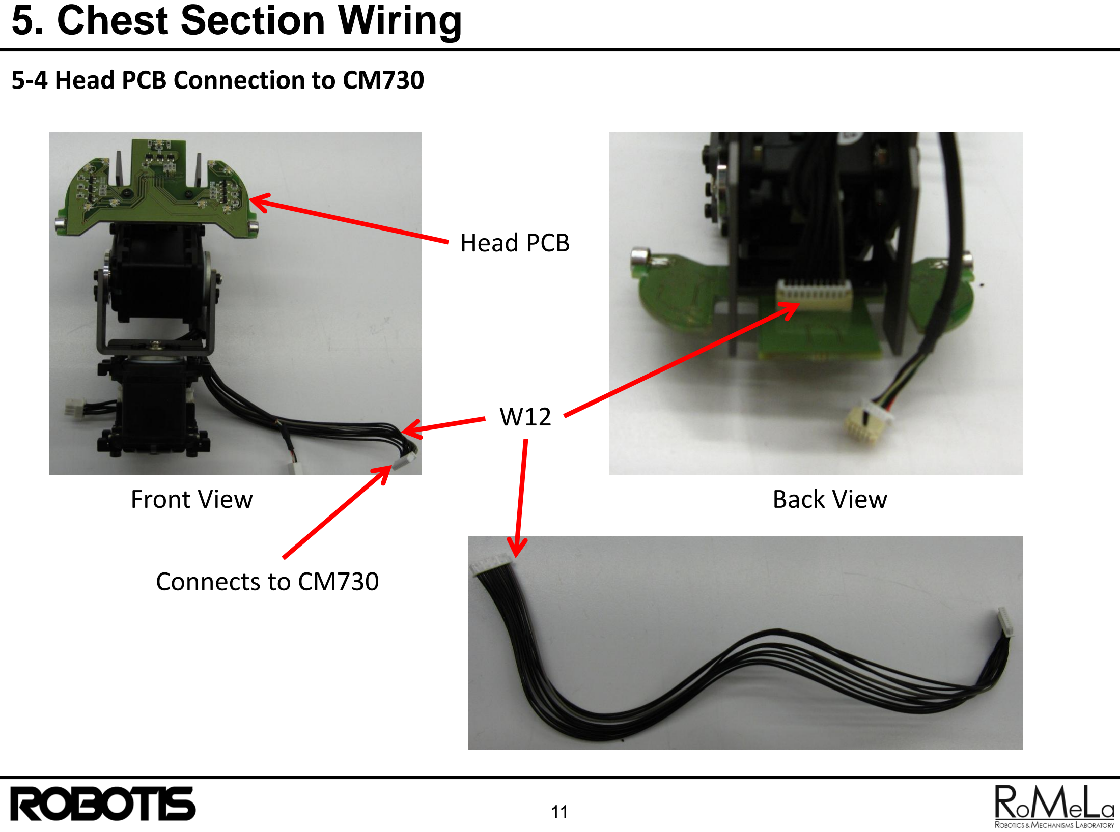
[picture p129: page 11]

W12

Front View | Back View

## Head PCB

## Connects to CM730

# 5. Chest Section Wiring

## 5-5 Camera PCB to CM730

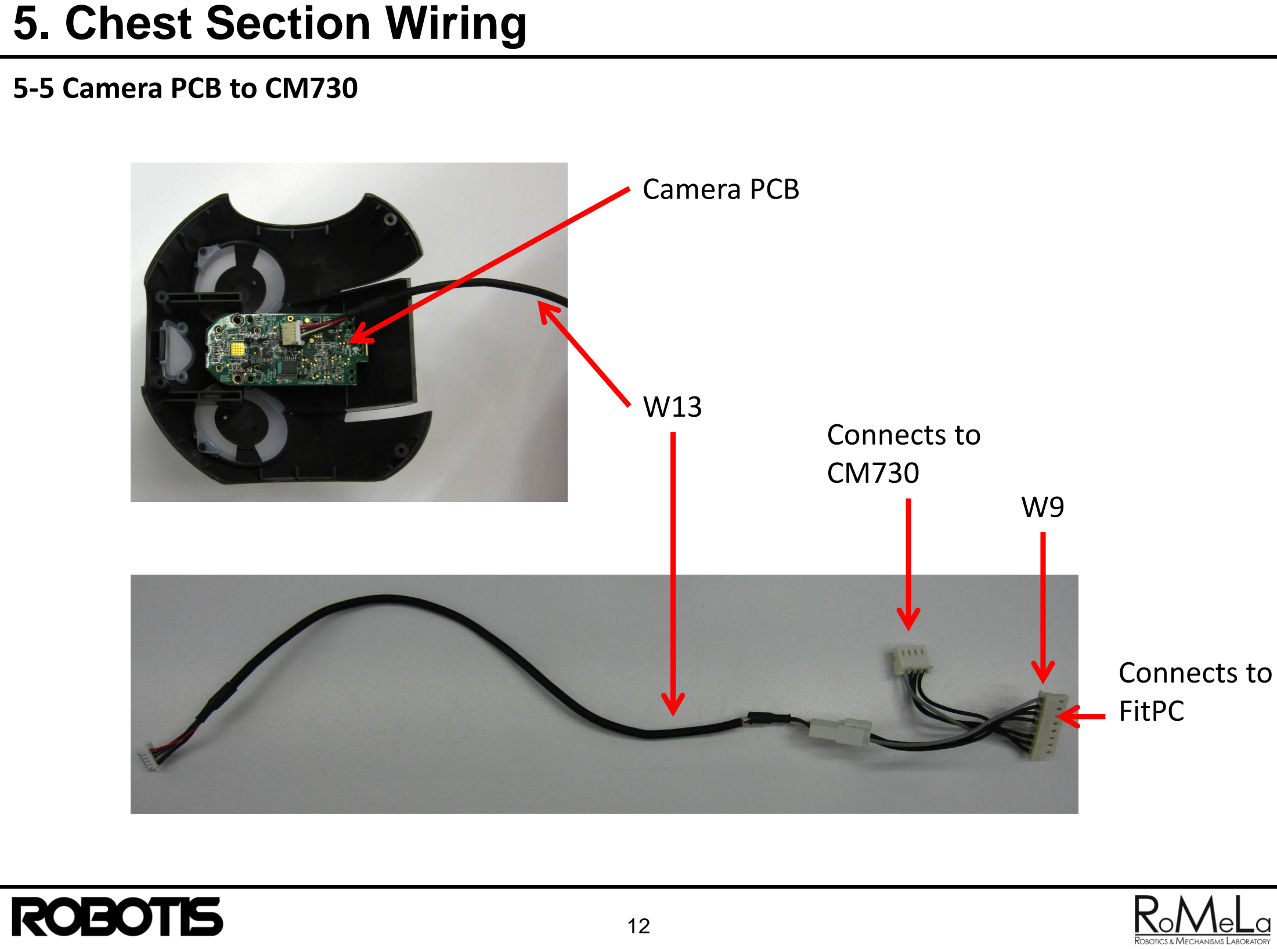
[picture p130: page 12]

W13

W9

## Camera PCB

## Connects to

CM730

## Connects to FitPC

# 5. Chest Section Wiring

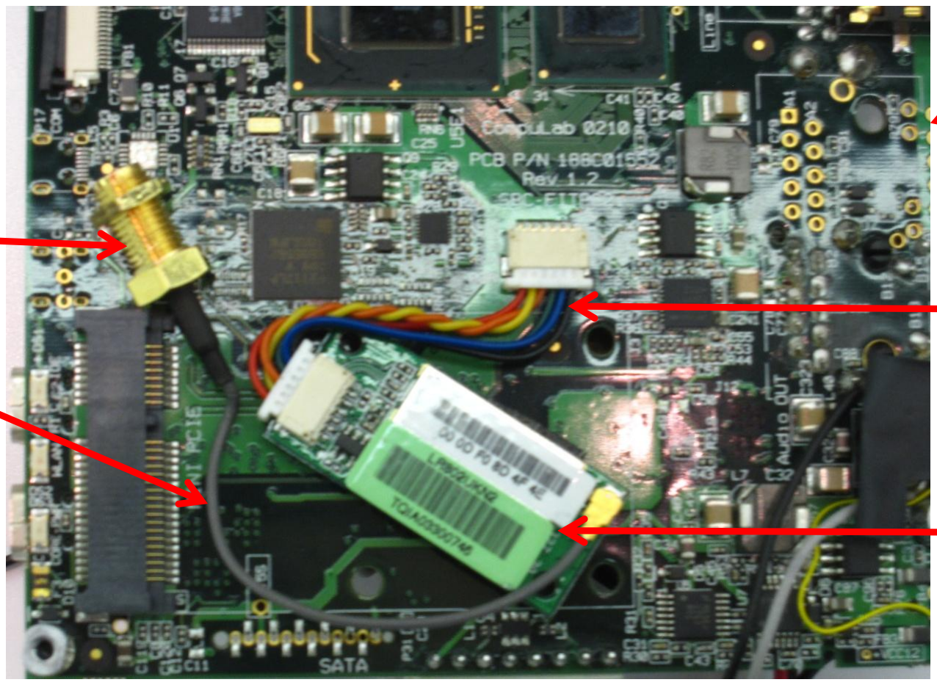
[picture p131: figure]

## Antenna Connector

W7

W8

## Antenna PCB

## 5-6 Antenna Wiring

## Backside of FitPC

# 5. Chest Section Wiring

## 5-7 FitPC Connection to CM730

FitPC Top Side | FitPC Bottom Side

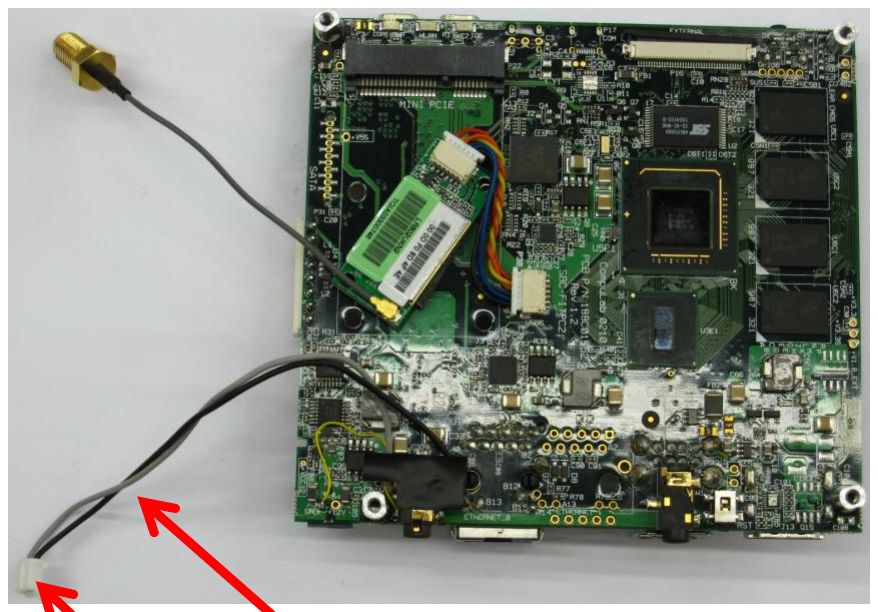
[picture p132: figure]
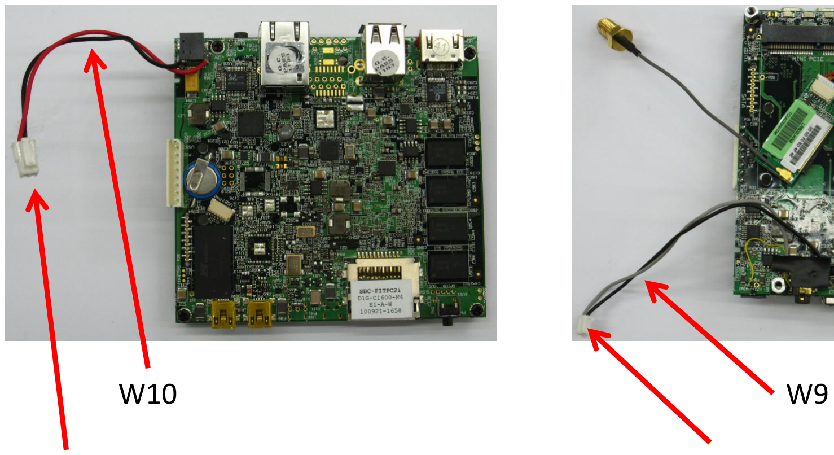
[picture p133: figure]

Connects to CM730 | Connects to CM730

# 6. Motor Wire Routing

## 6-1 Routing for the Head

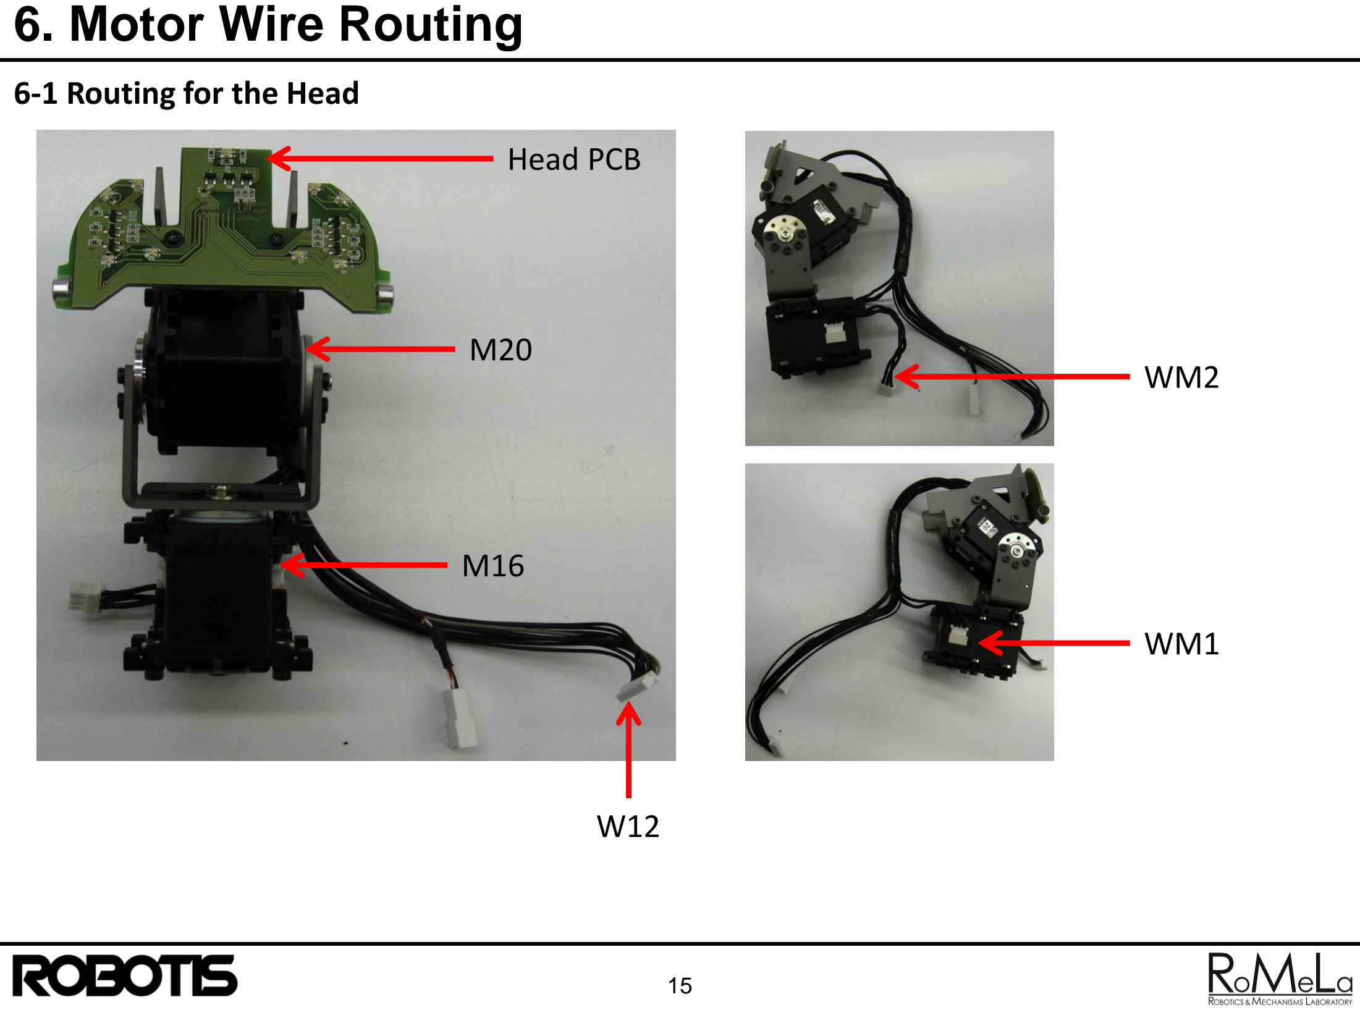
[picture p134: page 15]

M20

M16

W12

## Head PCB

WM1

WM2

# 6. Motor Wire Routing

## 6-2 Routing for the Arms

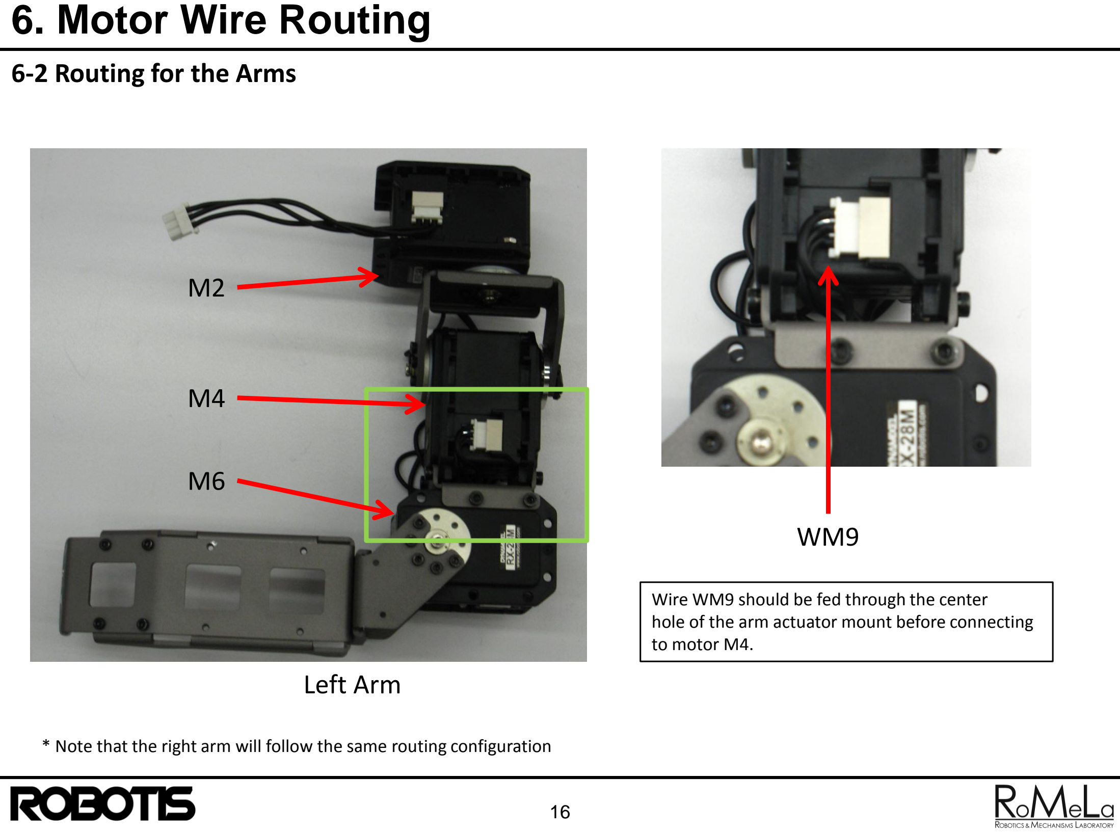
[picture p135: page 16]

## Left Arm

* Note that the right arm will follow the same routing configuration

M6

M4

M2

WM9

Wire WM9 should be fed through the center hole of the arm actuator mount before connecting to motor M4.

# 6. Motor Wire Routing

## 6-2 Routing for the Arms

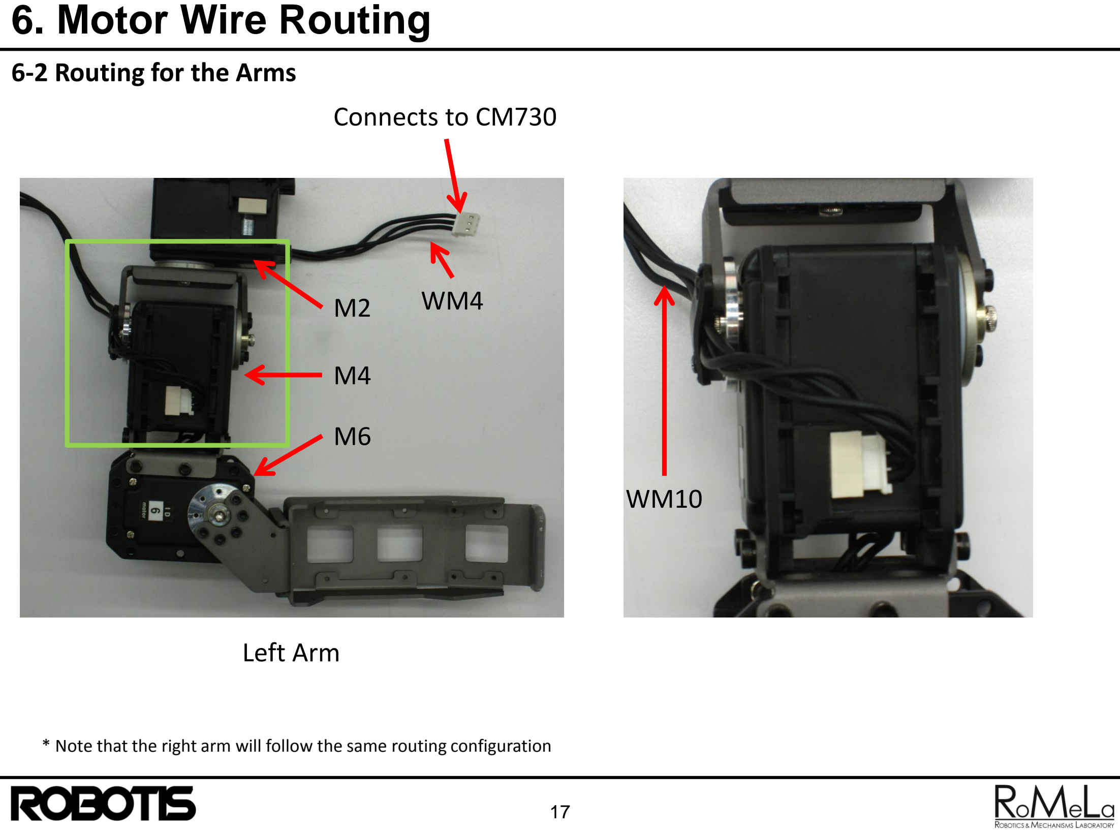
[picture p136: page 17]

## Left Arm

* Note that the right arm will follow the same routing configuration

M6

M4

M2

WM10

WM4

## Connects to CM730

# 6. Motor Wire Routing

## 6-2 Routing for the Arms

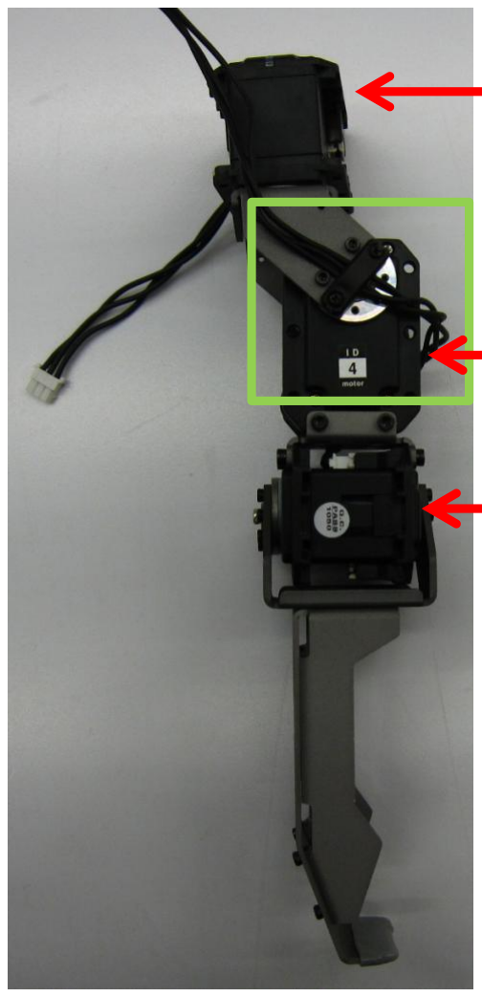
[picture p137: figure]

## Left Arm

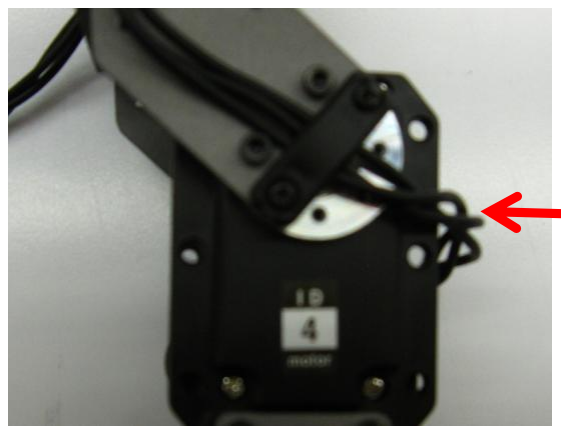
[picture p138: figure]
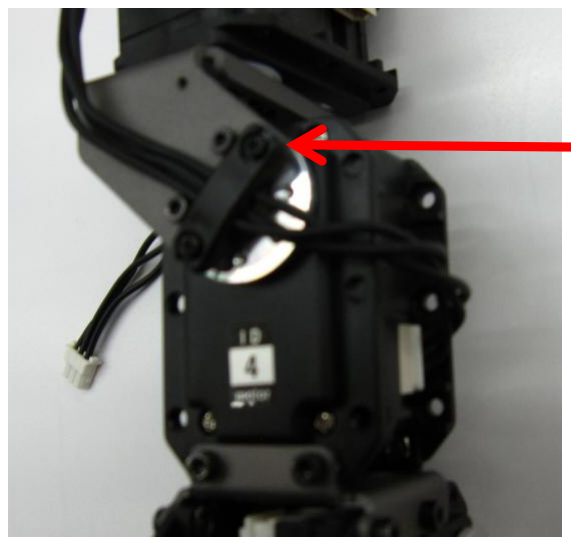
[picture p139: figure]

* Note that the right arm will follow the same routing configuration

M6

M4

M2

Attach the cable holder to keep wire WM10 from getting tangled.

WM10

## Cable Holder

# 6. Motor Wire Routing

## 6-3 Routing for the Legs

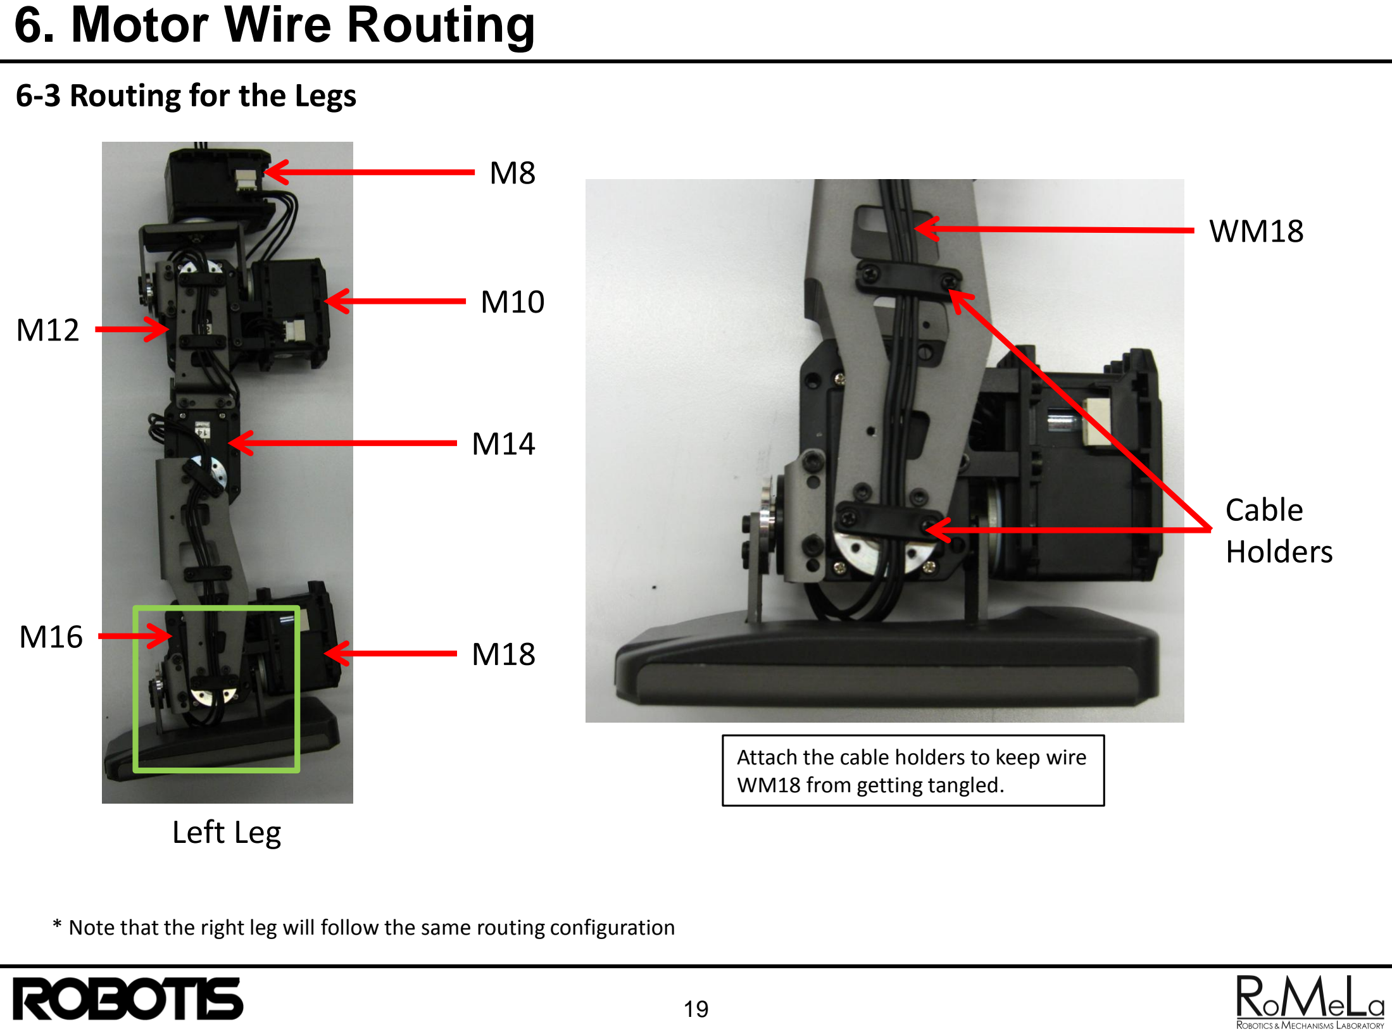
[picture p140: page 19]

## Left Leg

* Note that the right leg will follow the same routing configuration

M14

M10

M8

Attach the cable holders to keep wire WM18 from getting tangled.

WM18

## Cable Holders

M18

M12

M16

# 6. Motor Wire Routing

## 6-3 Routing for the Legs

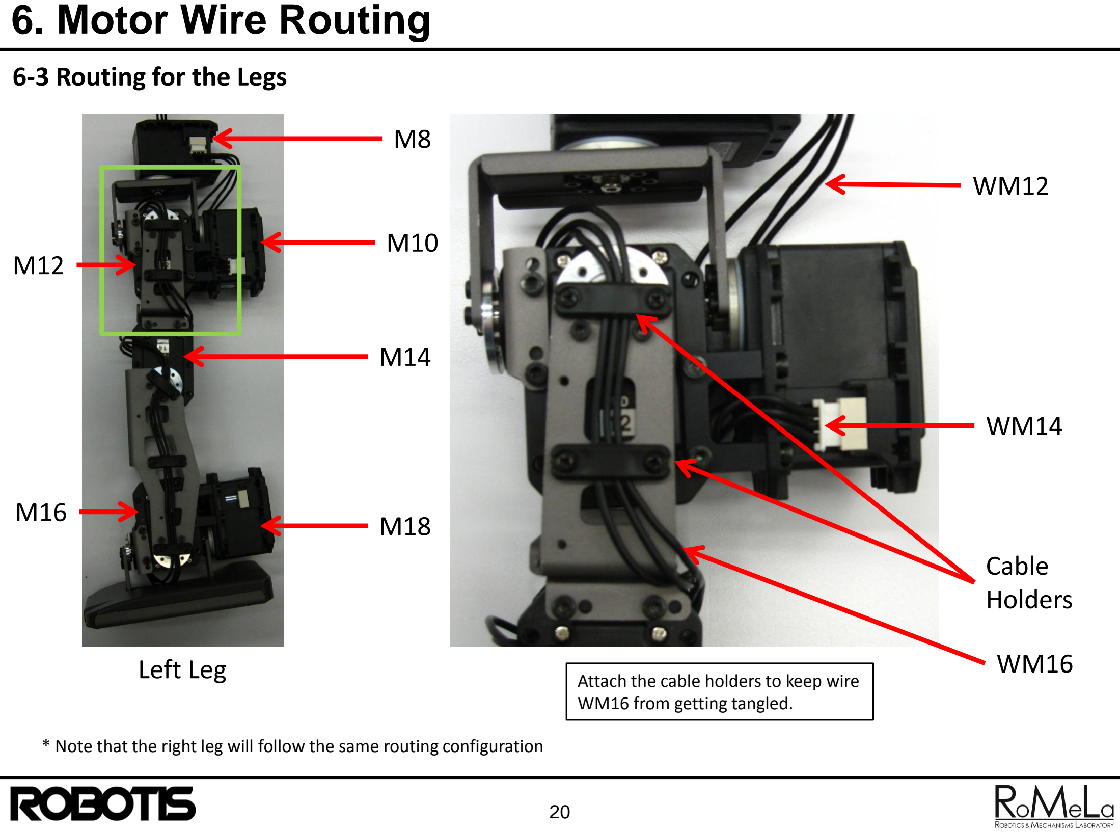
[picture p141: page 20]

## Left Leg

* Note that the right leg will follow the same routing configuration

M14

M10

M8

Attach the cable holders to keep wire WM16 from getting tangled.

WM12

## Cable Holders

M18

M12

M16

WM16

WM14

# 6. Motor Wire Routing

## 6-3 Routing for the Legs

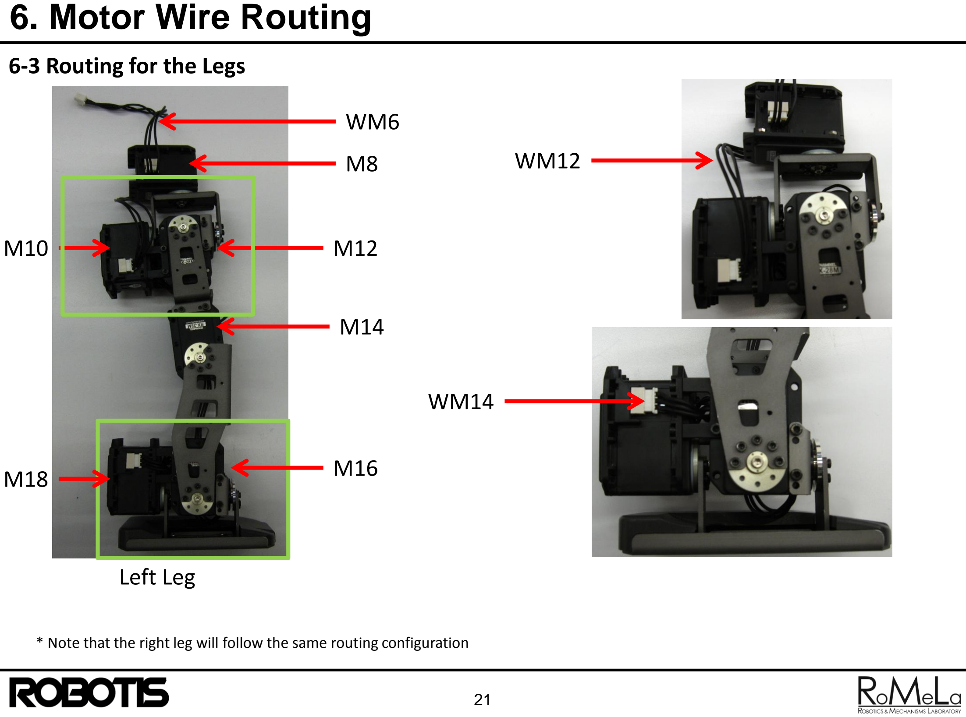
[picture p142: page 21]

## Left Leg

* Note that the right leg will follow the same routing configuration

M14

M12

M8 | WM12

M16

M10

M18

WM14

WM6

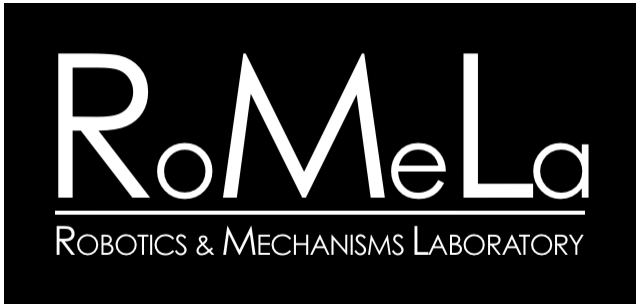
[picture p143: figure]
