ROBOTIS-GIT/ROBOTIS-OP-Series-Data/(threads)

Thread 1 (2019-05-07):

Is it Possible to Control Darwin-OP (1st Edition) with ROS

armandogranado, 2019-05-07:
Hi, I know you can send ROS commands to Darwin-OP 3. However, our team has the first Darwin-OP. Would it be possible to command it using ROS.

Robotis sent a document on downloading Ubuntu 9.01 on the hardware. However, even if we did do that, how can we ensure ROS commands will make it work.

Thanks for reading!

ROBOTIS-Kayman, 2019-05-08:
Hi,

To use ROS, you must install Ubuntu 14.04 or later. However, I think it difficult to install on darwin-op. If possible, the ros package for op2 can be used for darwin-op. This is op2 ros package. darwin-op is almost the same as robotis-op2, but it is slow (slow CPU processing).
- ROS packages
  - [ROBOTIS-OP2](https://github.com/ROBOTIS-GIT/ROBOTIS-OP2)
  - [ROBOTIS-OP2-COMMON](https://github.com/ROBOTIS-GIT/ROBOTIS-OP2-Common)
- [e-manual](http://emanual.robotis.com/docs/en/platform/op2/ros_package/#robotis-op2-ros-packages)

Regards,
Kayman

ROBOTIS-Kayman, 2019-06-10:
This issue will be closed since there were no actions for a while. You can reopen this issue to show this issue to the users whenever. Thanks.

juanjoseluciano, 2019-07-26:
Hi, I have some doubts, excuse my English, it's bad.
1.-Did you mention that I have to install ubuntu 14.04 in the darwin, or what version of ubuntu should I have installed to use ROS without any problem? because I read the darwin op2 documentation and it says that I must have higher ubuntu versions to install ROS both in the darwin and on my laptop (I currently have version 10.10 installed)
2.-The darwion op2 packages are compatible with darwin op1, does it not matter if the sub controller of one is 730 cm and the other 740 cm?
Thank you

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

ROBOTIS-Kayman, 2019-08-06:
Hi,
Sorry for the late reply.

1.Yes, you need to install ubuntu version 14.04 or higher on darwin-op2. If you are not using ROS on your laptop, you do not need to install Ubuntu 14.04 or higher on your laptop. If you are using ROS, you need to install it too.

2. Since op1 and op2 are the same hardware(MX-28), it seems that software can be applied. but it's difficult to install the latest version of Ubuntu on darwin-op1 due to lack of storage.

Regards,
Kayman

mggmauricio, 2019-09-01:
Hi, it's possible to use the Darwin Op2 with the OpenCr 1.0??

ROBOTIS-Kayman, 2019-09-05:
Hi,

OPENCR with robotis-op3 firmware can work on TTL communication. However, to
use both OPENCR and CM-740, you need to modify OPENCR's firmware. This is
because OPENCR and CM-740 are the same ID.

To replace the CM-740 with OPENCR, you need to install a communication
board such as U2D2 on robotis-op2. OPENCR works as a sensor board on
robotis-op3.

Regards,
Kayman

------------------------------------------------------------------------------------

Kayman Jung (kmjung@robotis.com)
R&D / Senior Research Engineer

ROBOTIS CO., LTD. (http://www.robotis.com)

ROBOTIS Campus,
37, Magokjungang 5-ro 1-gil,
Gangseo-gu, Seoul, Korea 07594
Tel : +82-70-8671-2838, Fax: +82-70-8230-1336

2019년 9월 2일 (월) 오전 7:10, mggmauricio <notifications@github.com>님이 작성:

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

Thread 2 (2024-09-27):

Wrong model

Dobrokvashina, 2024-09-27:
You have a wrong model of the arm in the Thormang3 style skin. In the picture you have the arm which looks like this
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
BUT in the archive the model on the arm has other appearance (see the model near elbow joint - in the preview picture there is a cut which is not presented in the real model)
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
Because of this difference robot could not move properly in elbow joint with this skin. Please notice and check models.
