ROBOTIS-GIT/ROBOTIS-OP-Series-Data/ROBOTIS-OP3/Hardware/Electronics/Boards/JST_4P_EXT_5Port_Board_170213.pdf

5

4

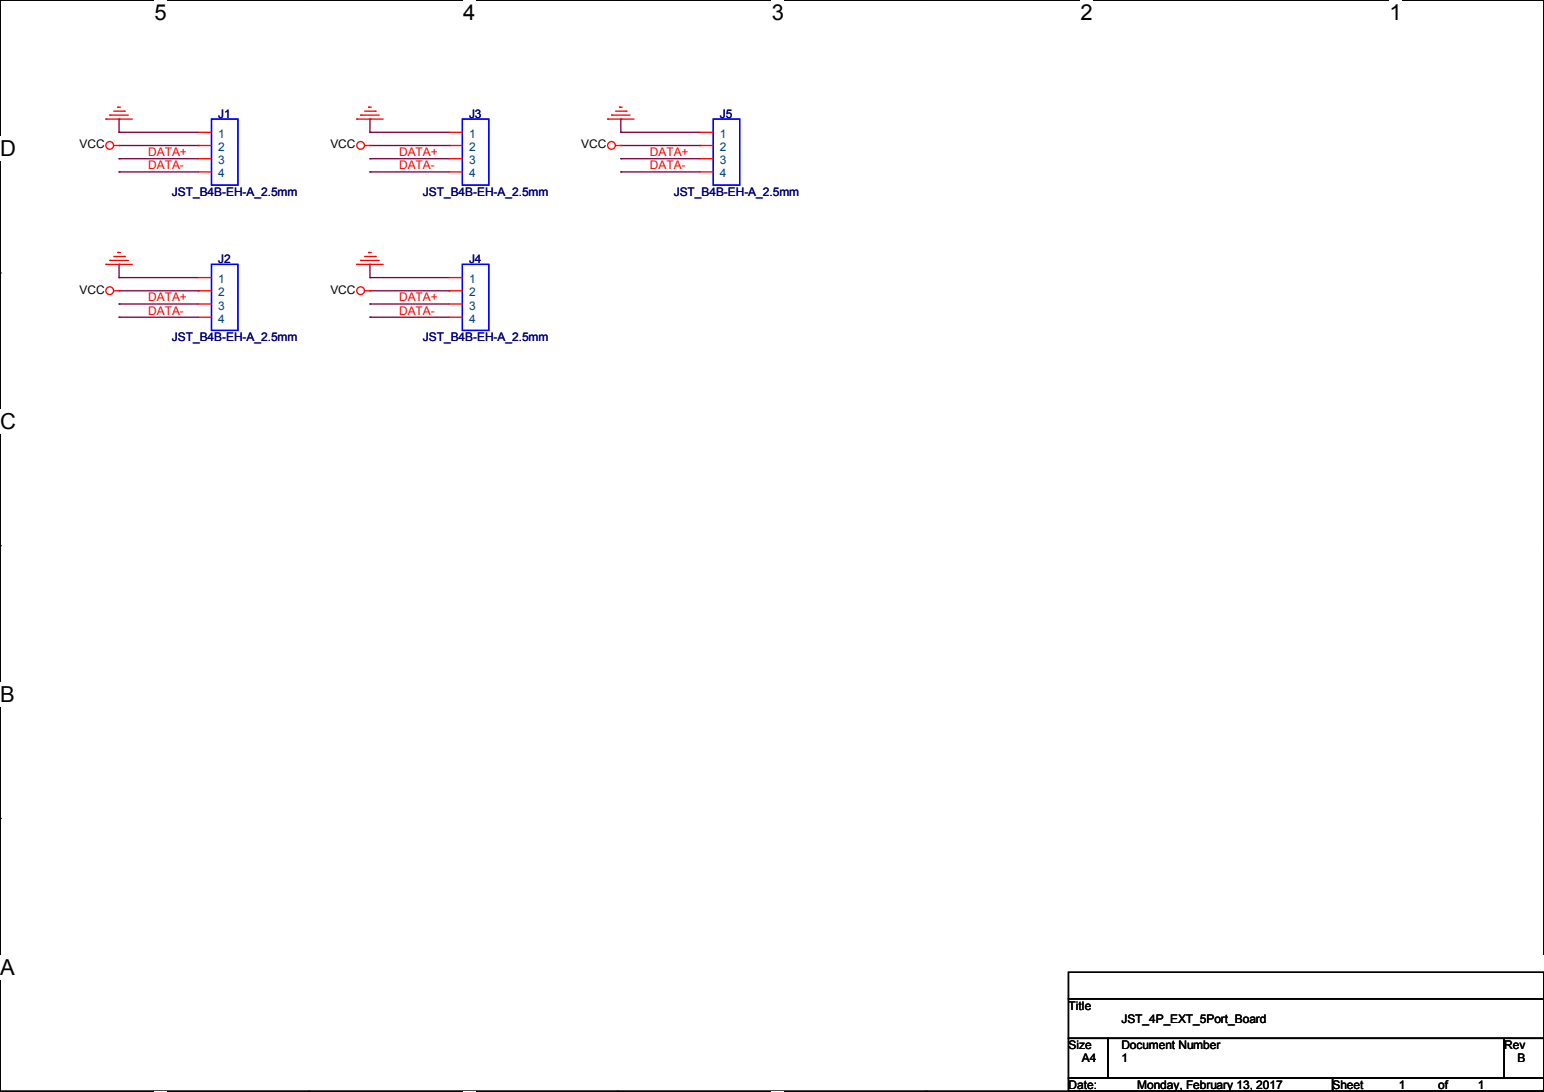
[picture p144: page 1]
DATA+ DATA-; VCC; Title; Size; Document Number; Rev; Date:; Sheet; JST_4P_EXT_5Port_Board; Monday, February 13, 2017; JST_B4B-EH-A_2.5mm
