ROBOTIS-GIT/ROBOTIS-OP-Series-Data/ROBOTIS-OP3/Hardware/Electronics/Boards/OP3_GPIO_Board_170213.pdf

# GPIO-Board_RGB_LED

Function Link | GPIO Board Connect

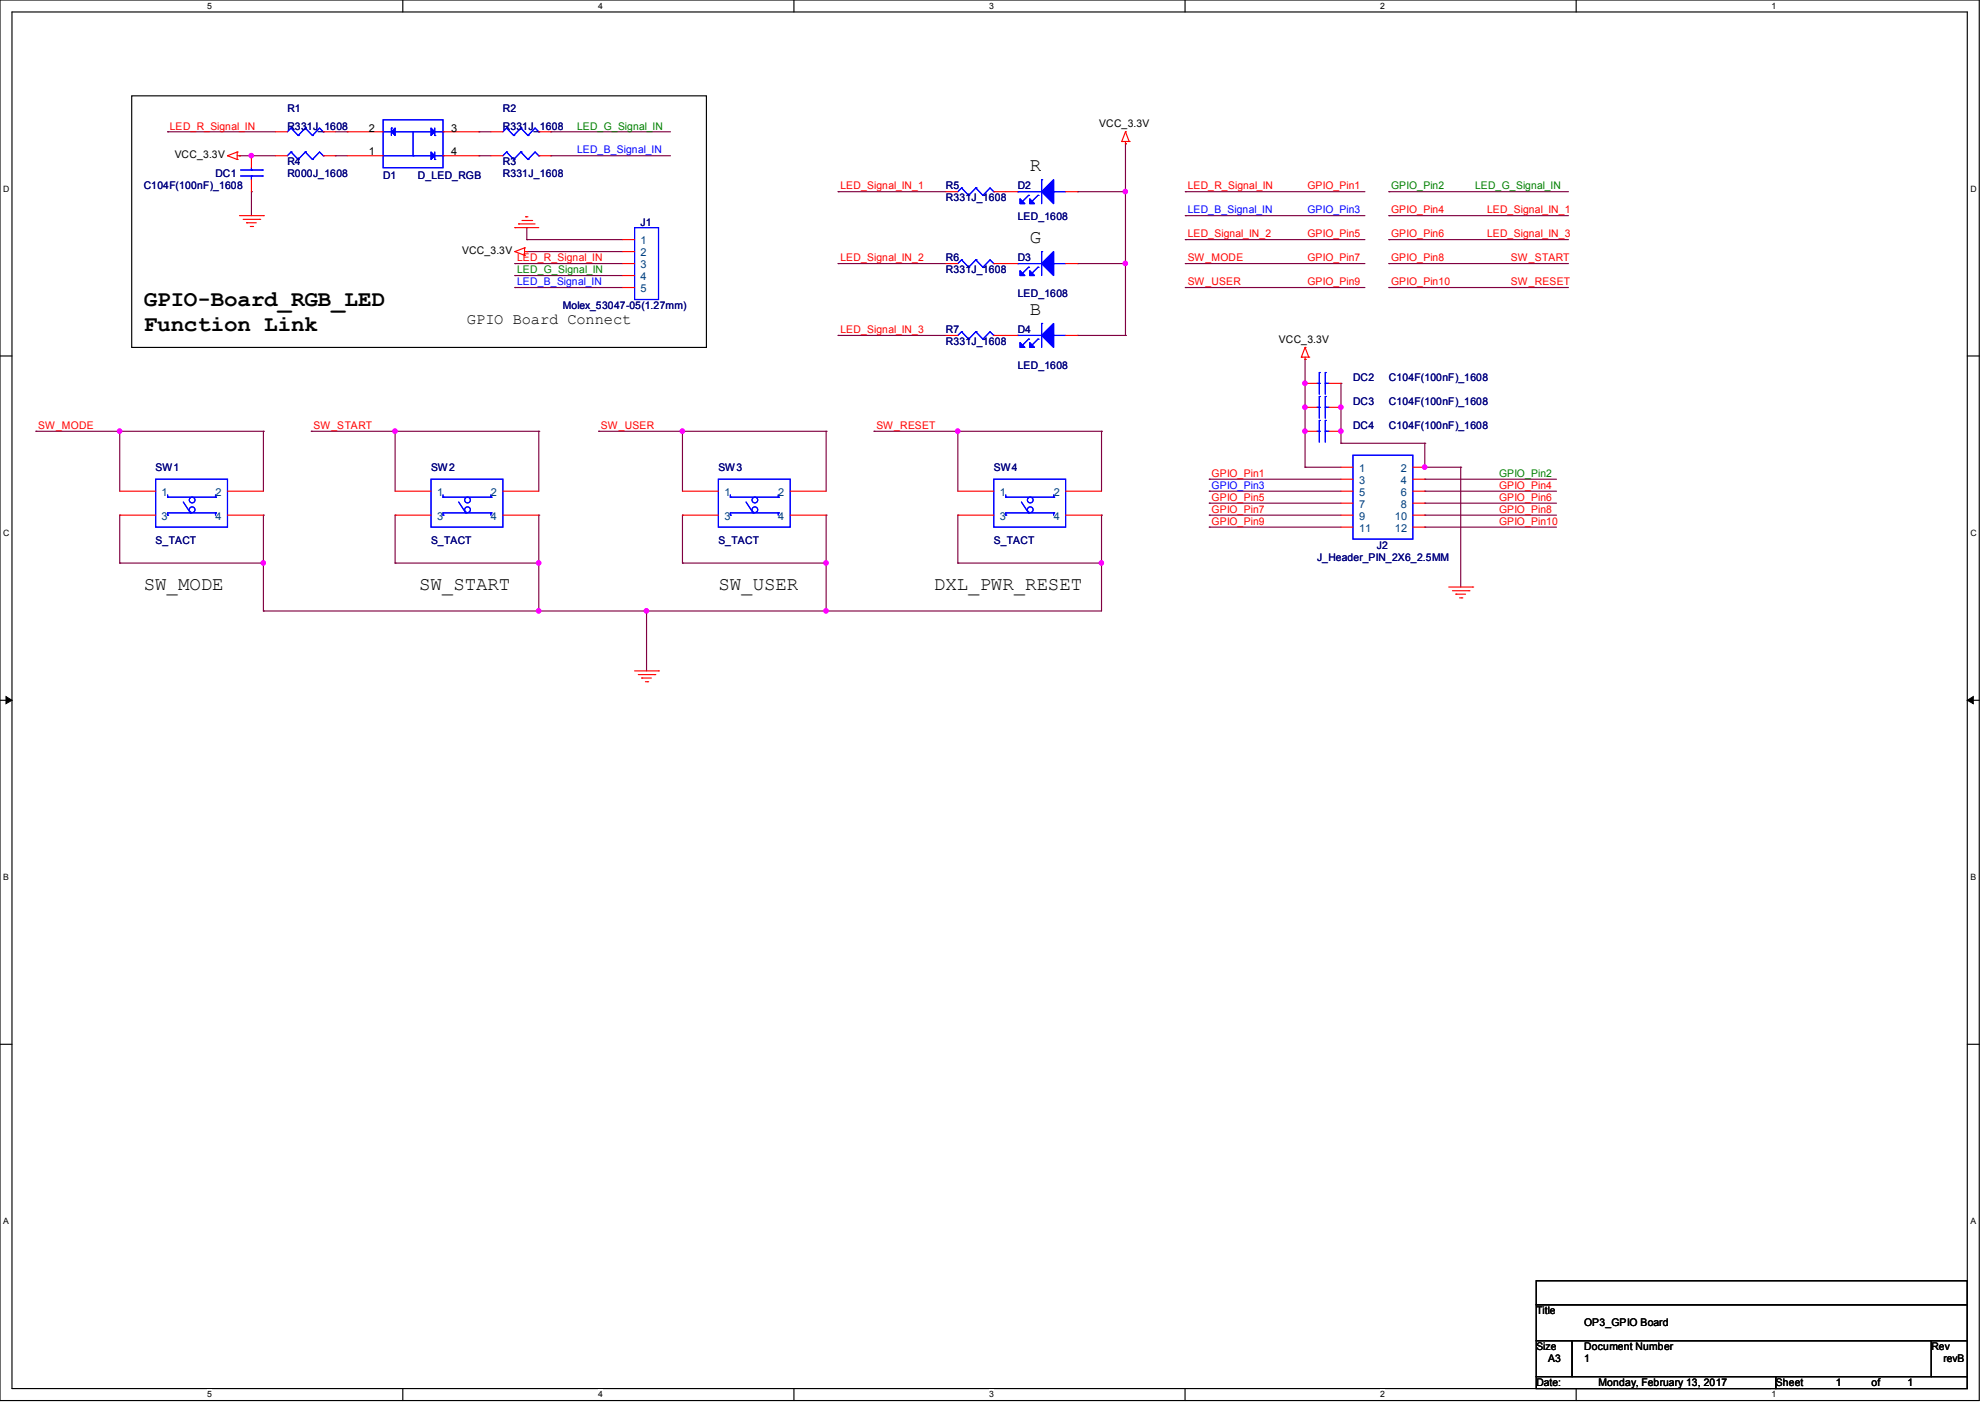
[picture p145: page 1]
