ROBOTIS-GIT/ROBOTIS-OP-Series-Data/ROBOTIS-OP3/Hardware/Electronics/Boards/OP3_LED-AMP_Board_170213.pdf

# GPIO-Board_RGB_LED Function Link

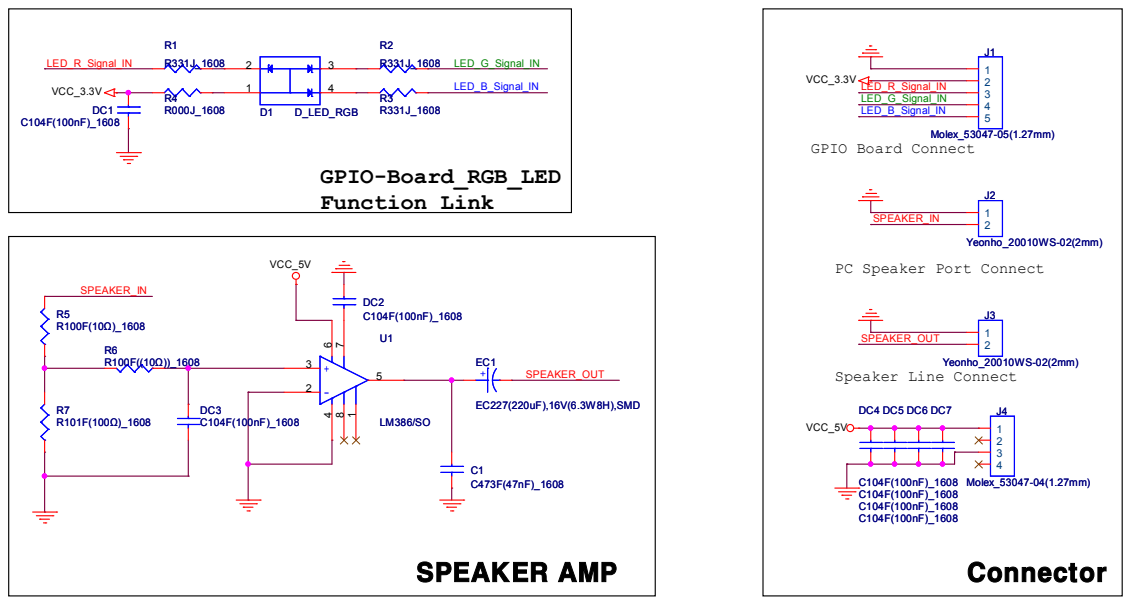
[picture p146: page 1]

PC Speaker Port Connect
