ROBOTIS-GIT/ROBOTIS-OP-Series-Data/ROBOTIS-OP, ROBOTIS-OP2/Hardware/Electronics/Sub Controller/ROBOTIS-OP2_Subcontroller_Schematics.pdf

ISP CONNECTOR | BUZZER

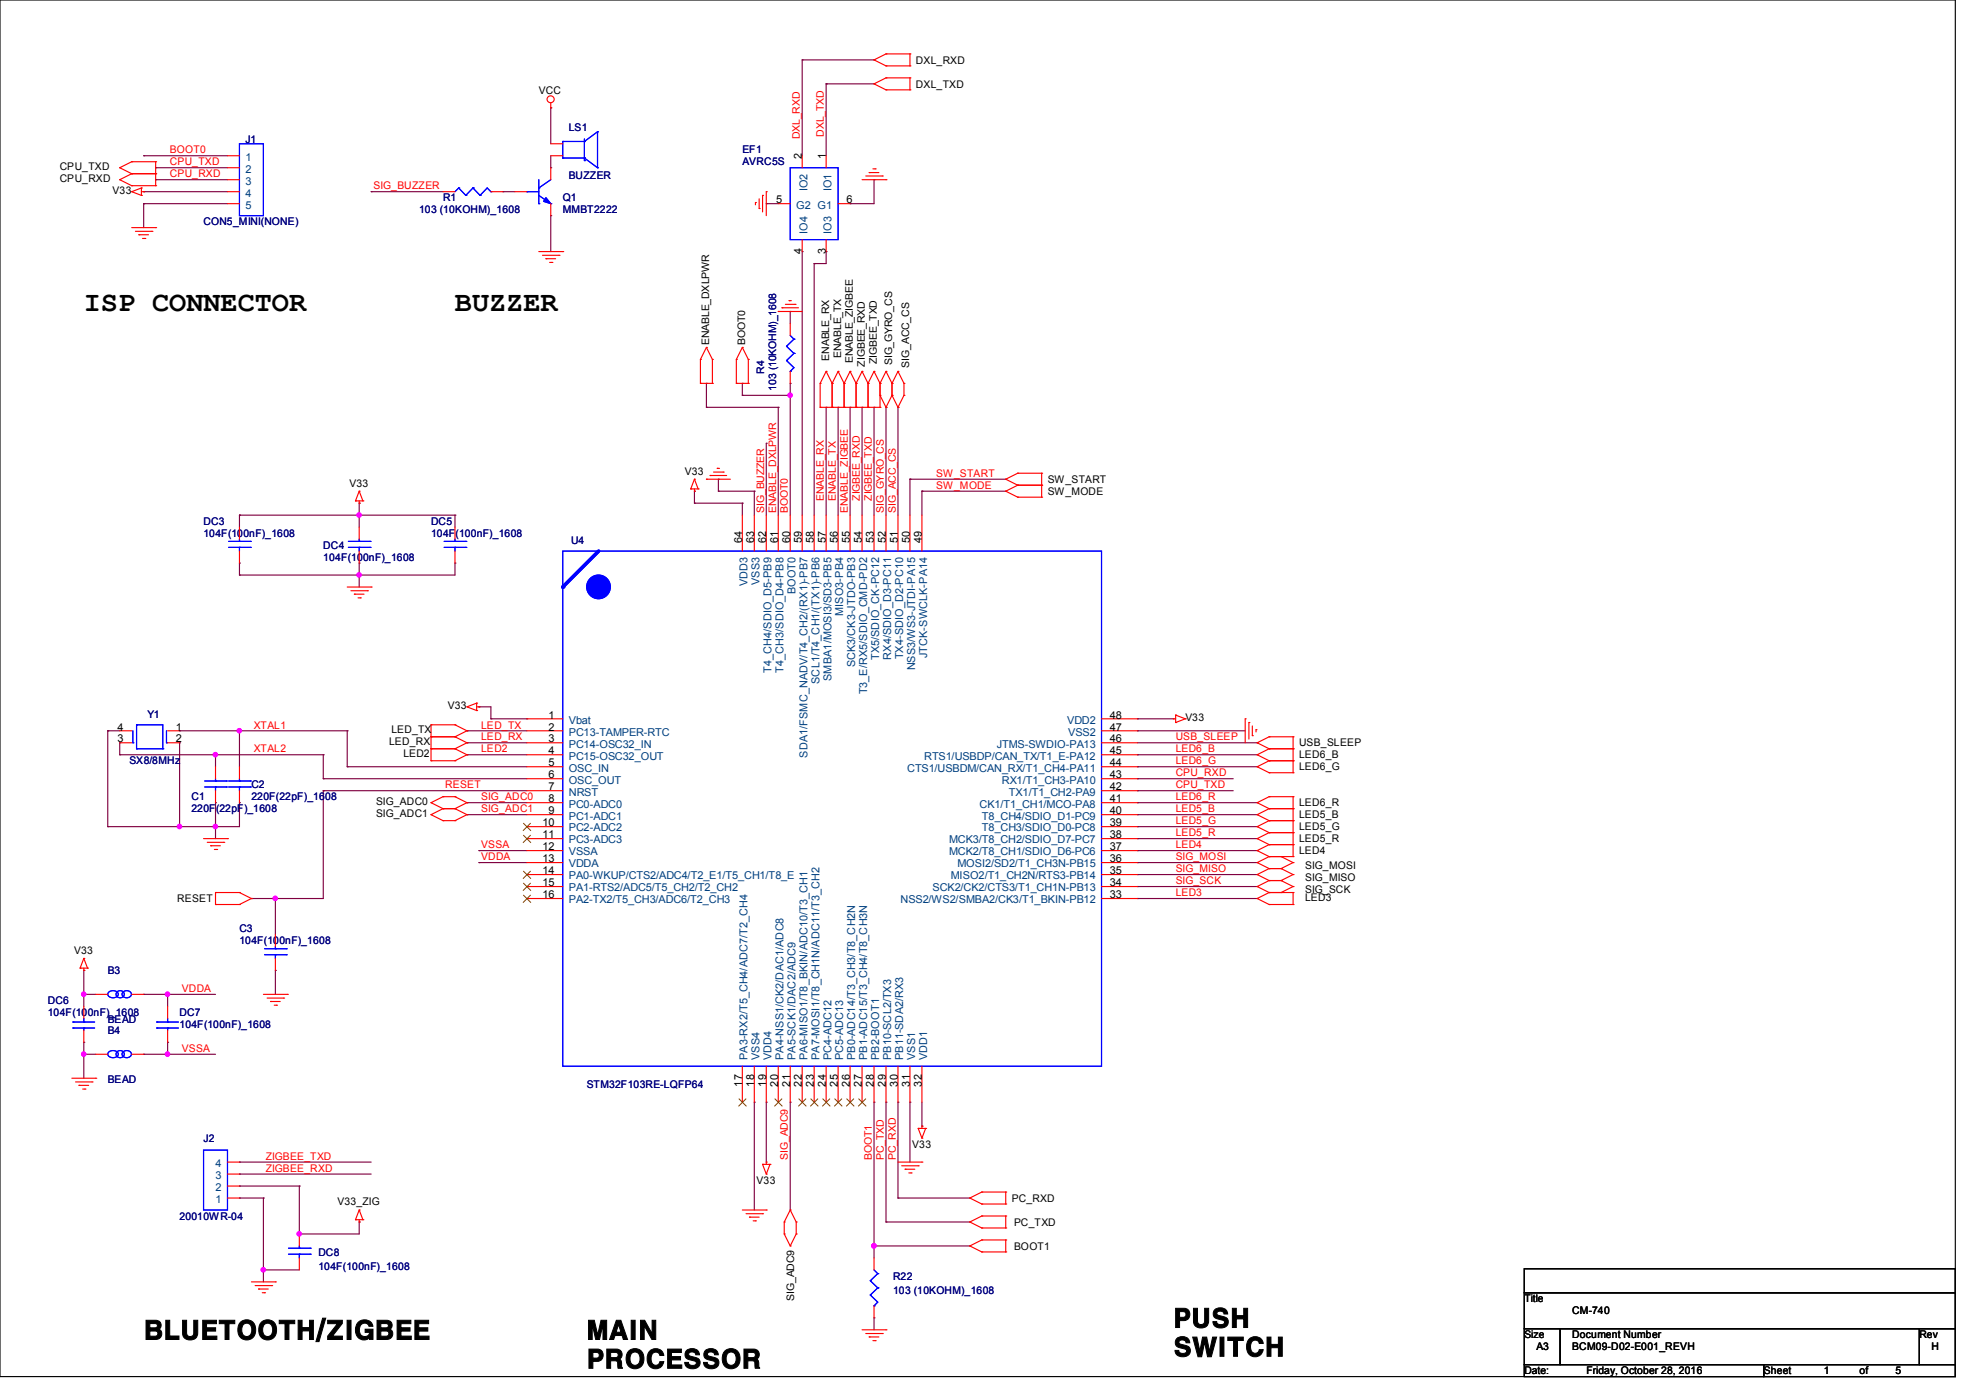
[picture p147: page 1]

V33

V33

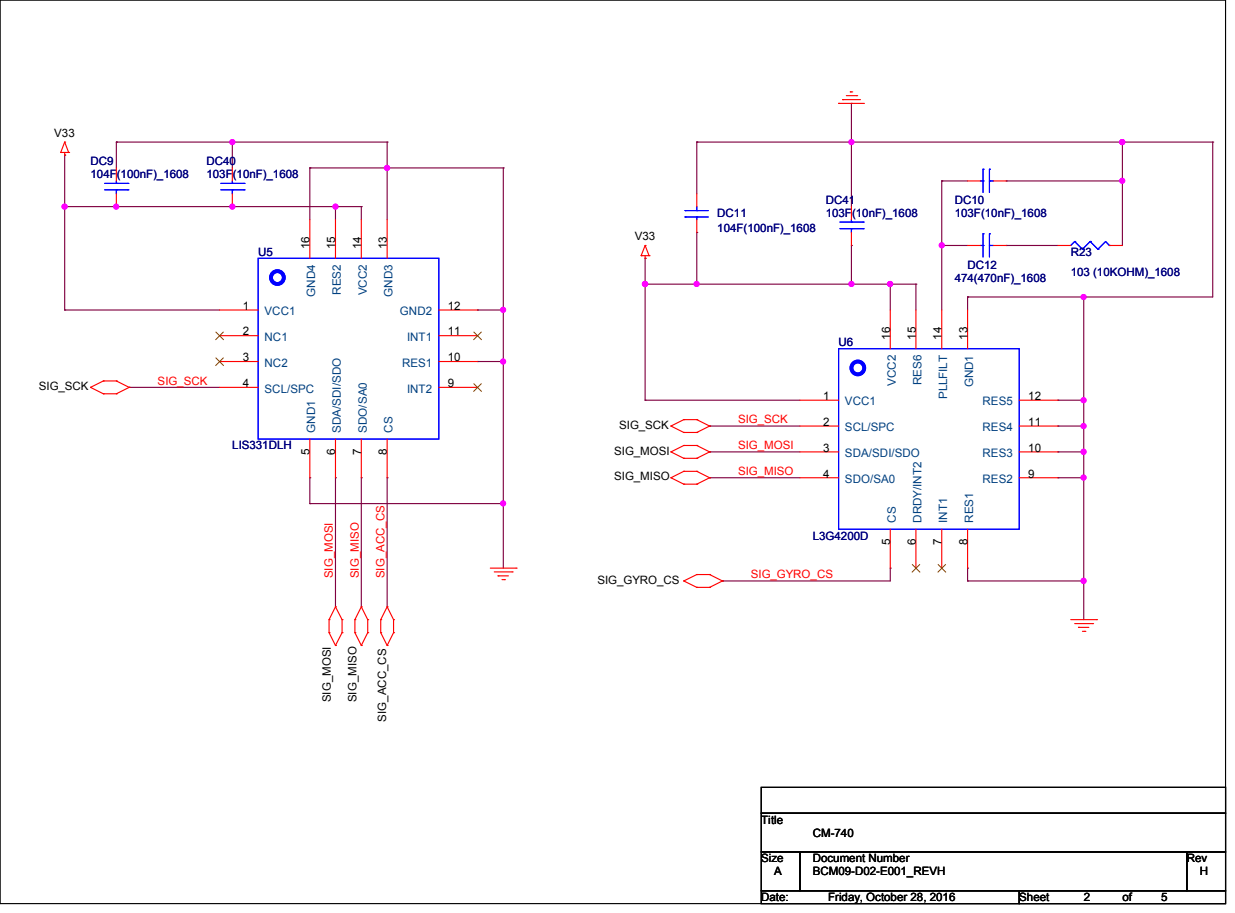
[picture p148: page 2]
SIG_MOSI; SIG_MISO; SIG_ACC_CS; SIG_SCK; SIG_GYRO_CS; Title; BCM09-D02-E001_REVH; Friday, October 28, 2016; 103 (10KOHM)_1608; VCC1 1; SCL/SPC 2; SDO/SA0 4; DRDY/INT2 6; INT1 7; RES1 8; RES2; RES3; RES4; RES5; GND1 13; PLLFILT 14; RES6 15; VCC2 16; LIS331DLH; SCL/SPC 4; GND¹ 5; SDO/SA0 7; INT2; RES1; INT1; GND2; GND3 13; VCC2 14; RES2 15; GND4 16

SDA/SDI/SDO 6

SDA/SDI/SDO 3

# INTERFACE CONNECTOR

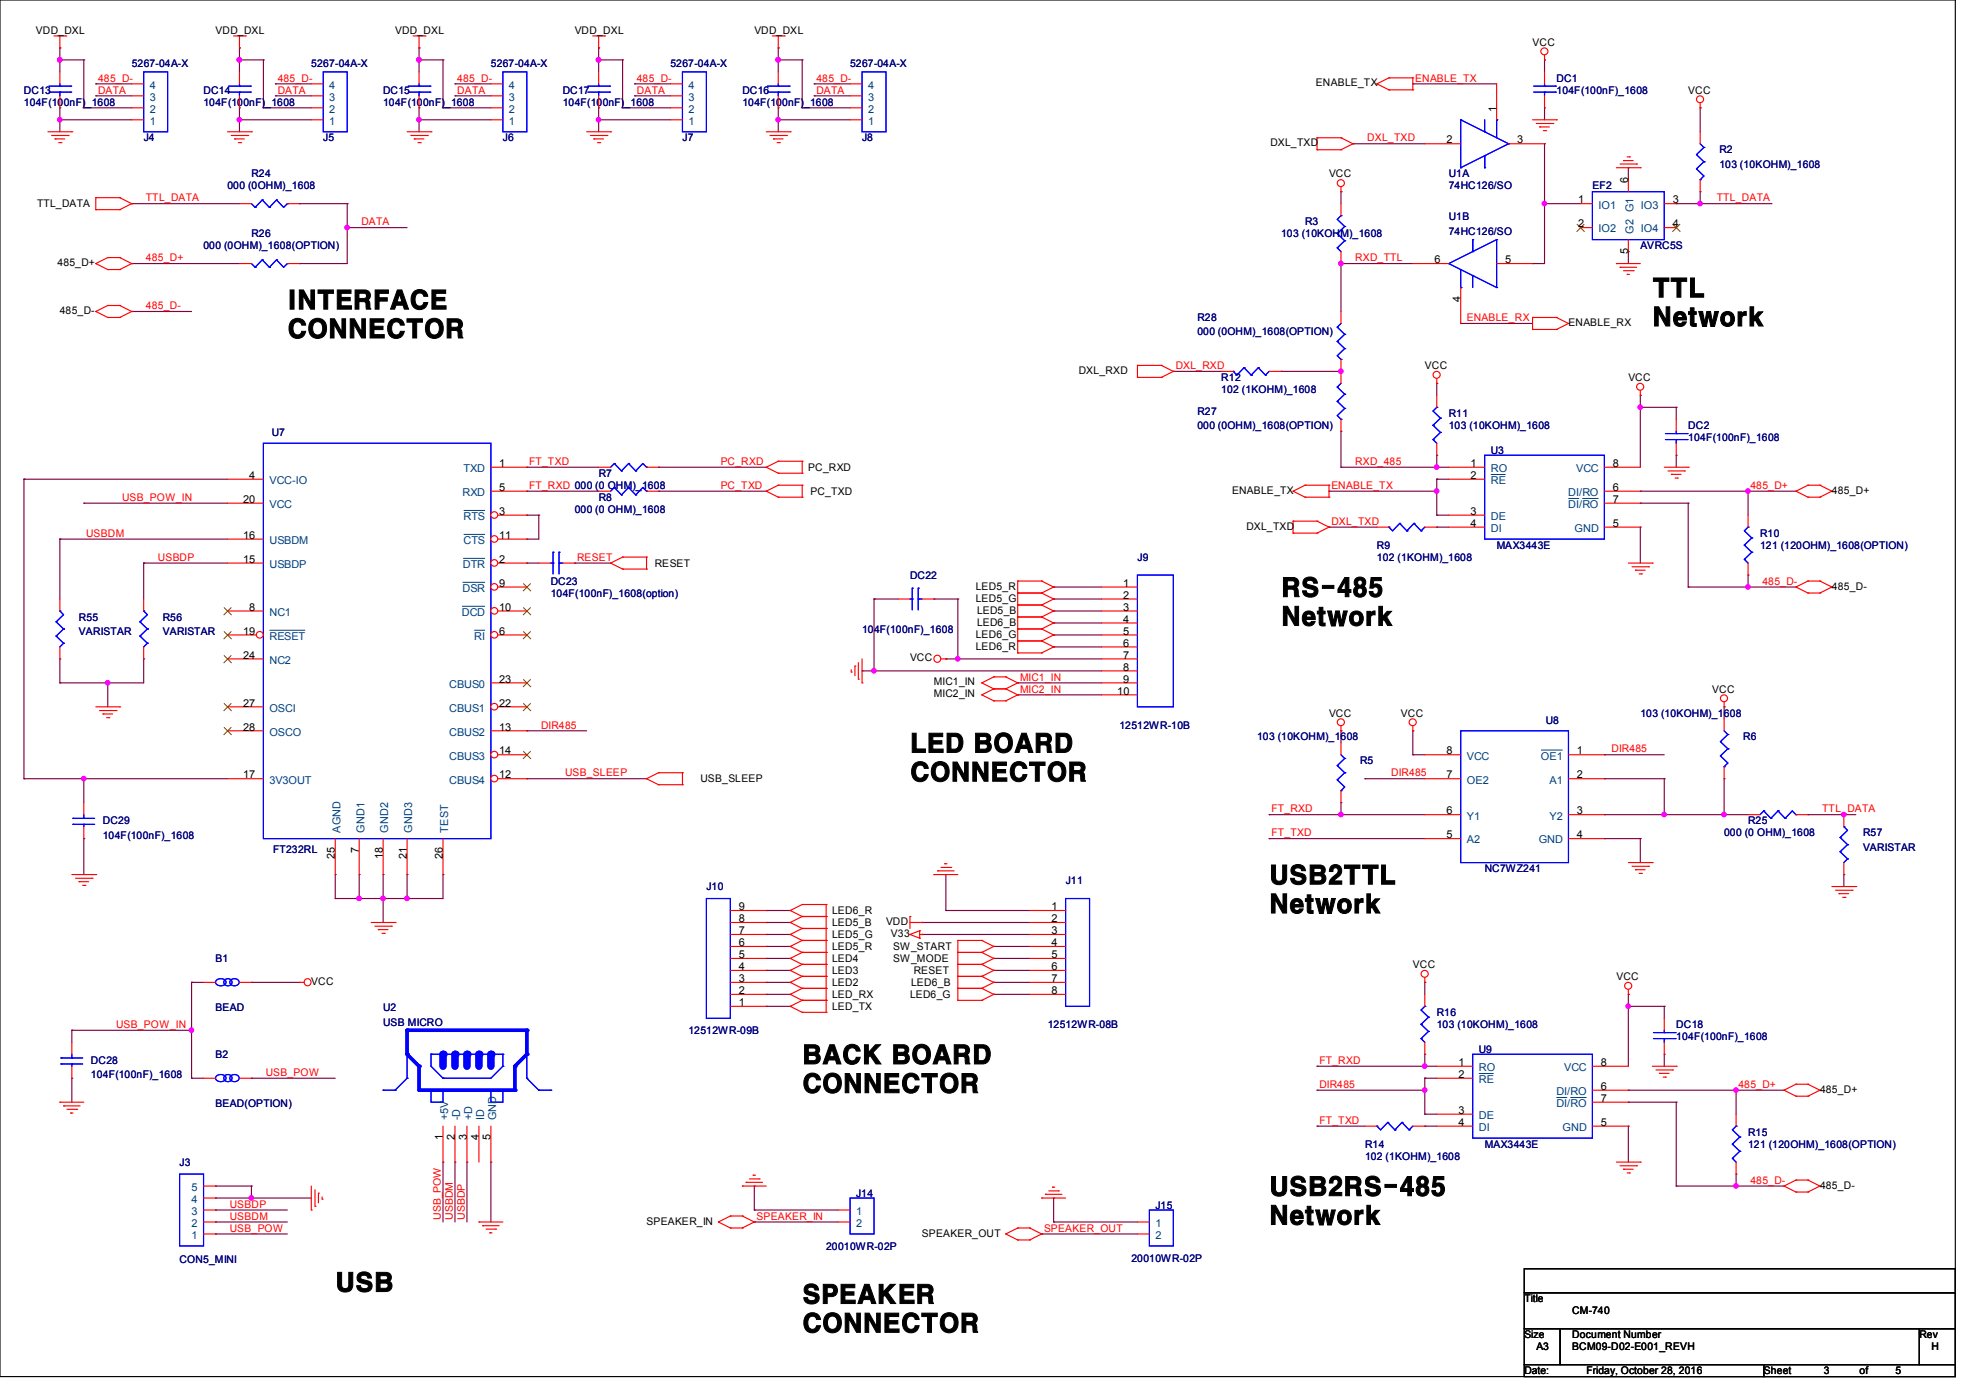
[picture p149: page 3]

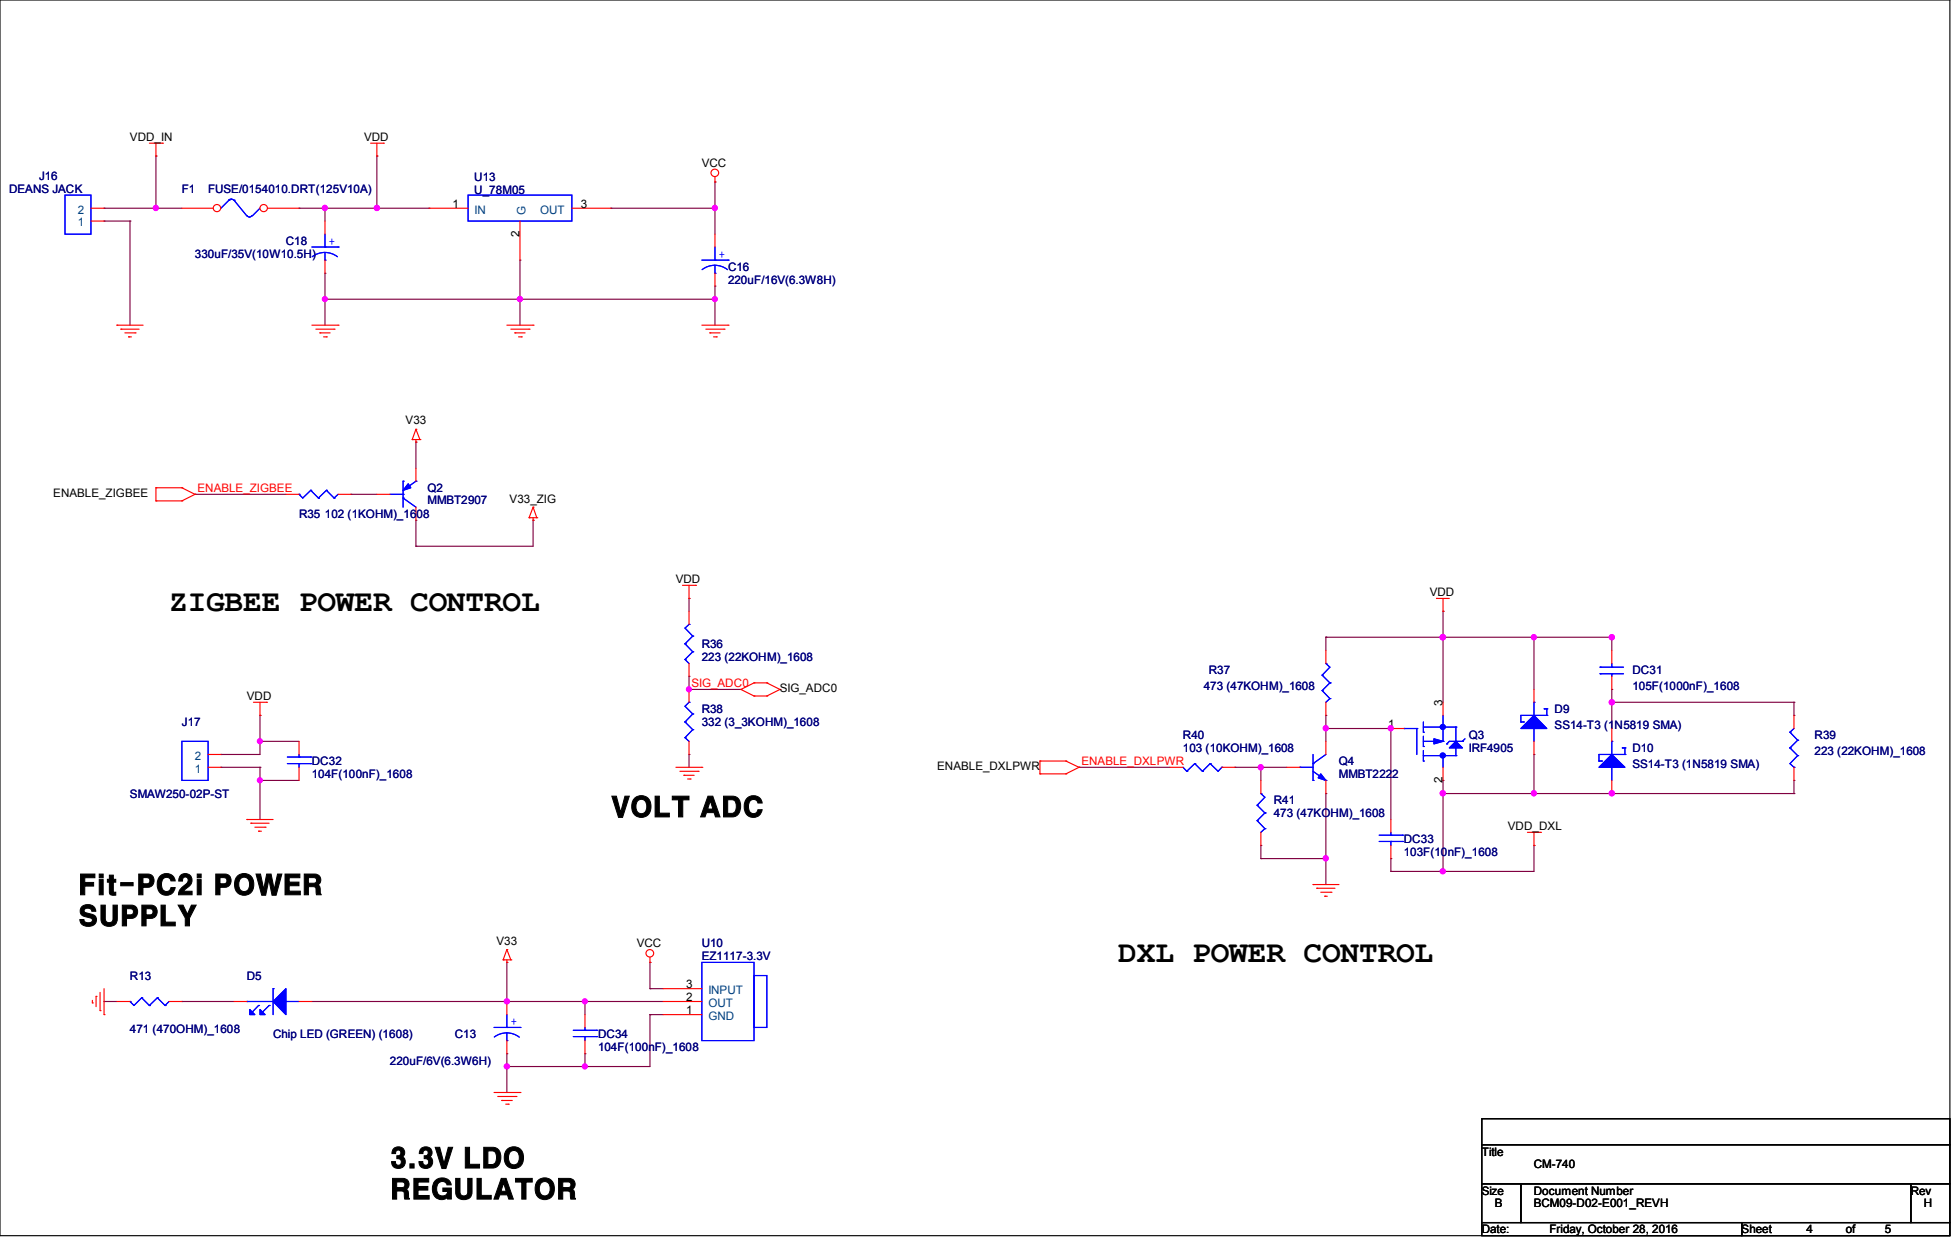
[picture p150: page 4]

## SPEAKER_OUT

## SPEAKER_IN

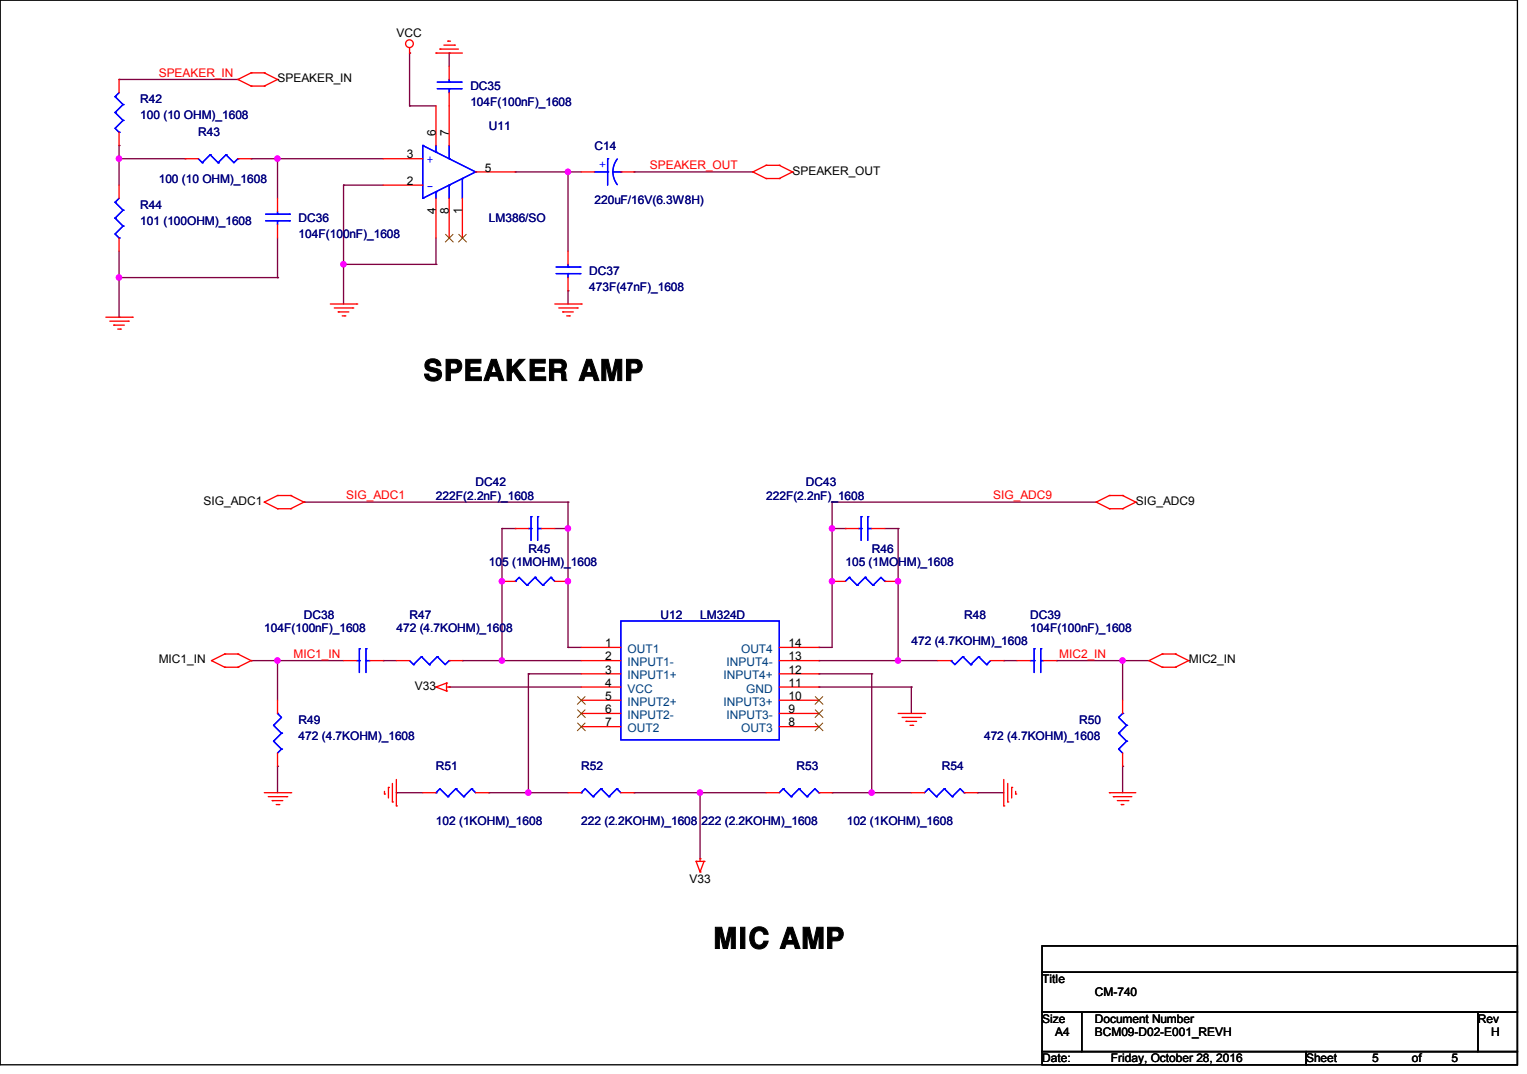
[picture p151: page 5]
