ROBOTIS-GIT/ROBOTIS-OP-Series-Data/ROBOTIS-OP, ROBOTIS-OP2/Overall/DARwIn-OP_Block_Diagram_Ver1.0.2.pdf

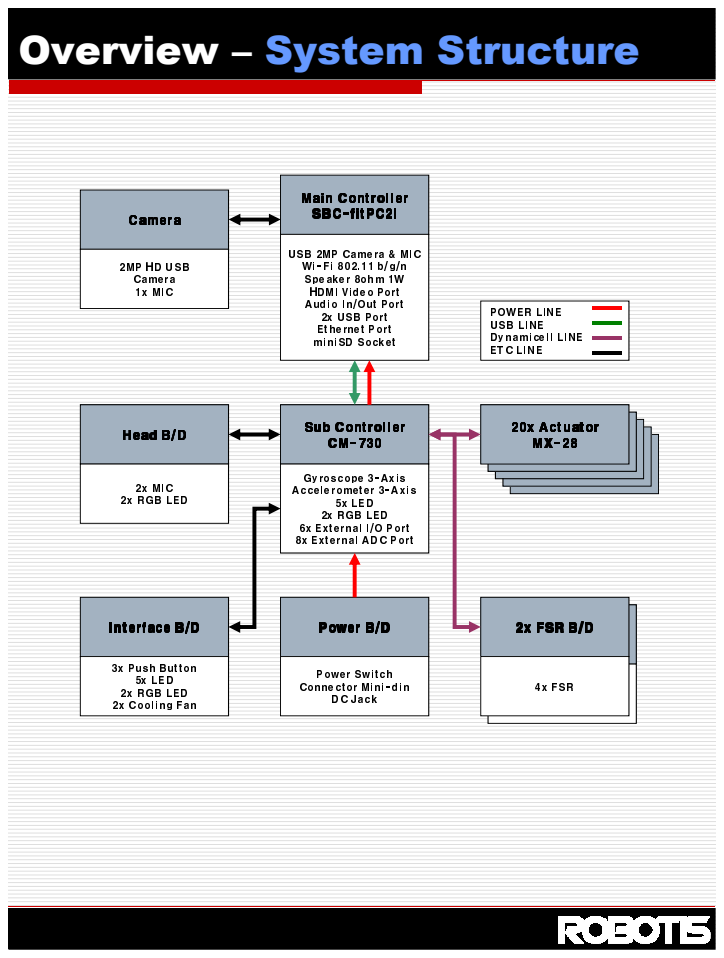
[picture p152: page 1]
Sub Controller CM-730; Head B/D; USB LINE ETC LINE; Camera Camera 1x MIC; FSR B/D; 4x FSR; 5x LED; 2x MIC; Power B/D; DC Jack; 2x FSR B/D

Overview – System Structure
Main Controller
SBC-fitPC2i fitPC2i
USB 2MP Camera & MIC
2MP HD USB
Speaker 8ohm 1W
HDMI Video Port
Audio In/Out Port
POWER LINE
2x USB Port
Ethernet Port
Dynamicell LINE
miniSD Socket
20x Actuator
Actuator
Accelerometer 3-Axis
2x RGB LED
6x External I/O Port
8x External ADC Port
Interface B/D
3x Push Button
Power Switch
Connector Mini-din
2x Cooling Fan
