ROBOTIS-GIT/ROBOTIS-OP-Series-Data/ROBOTIS-OP, ROBOTIS-OP2/Hardware/Electronics/Boards/DARwIn-OP_Head.pdf

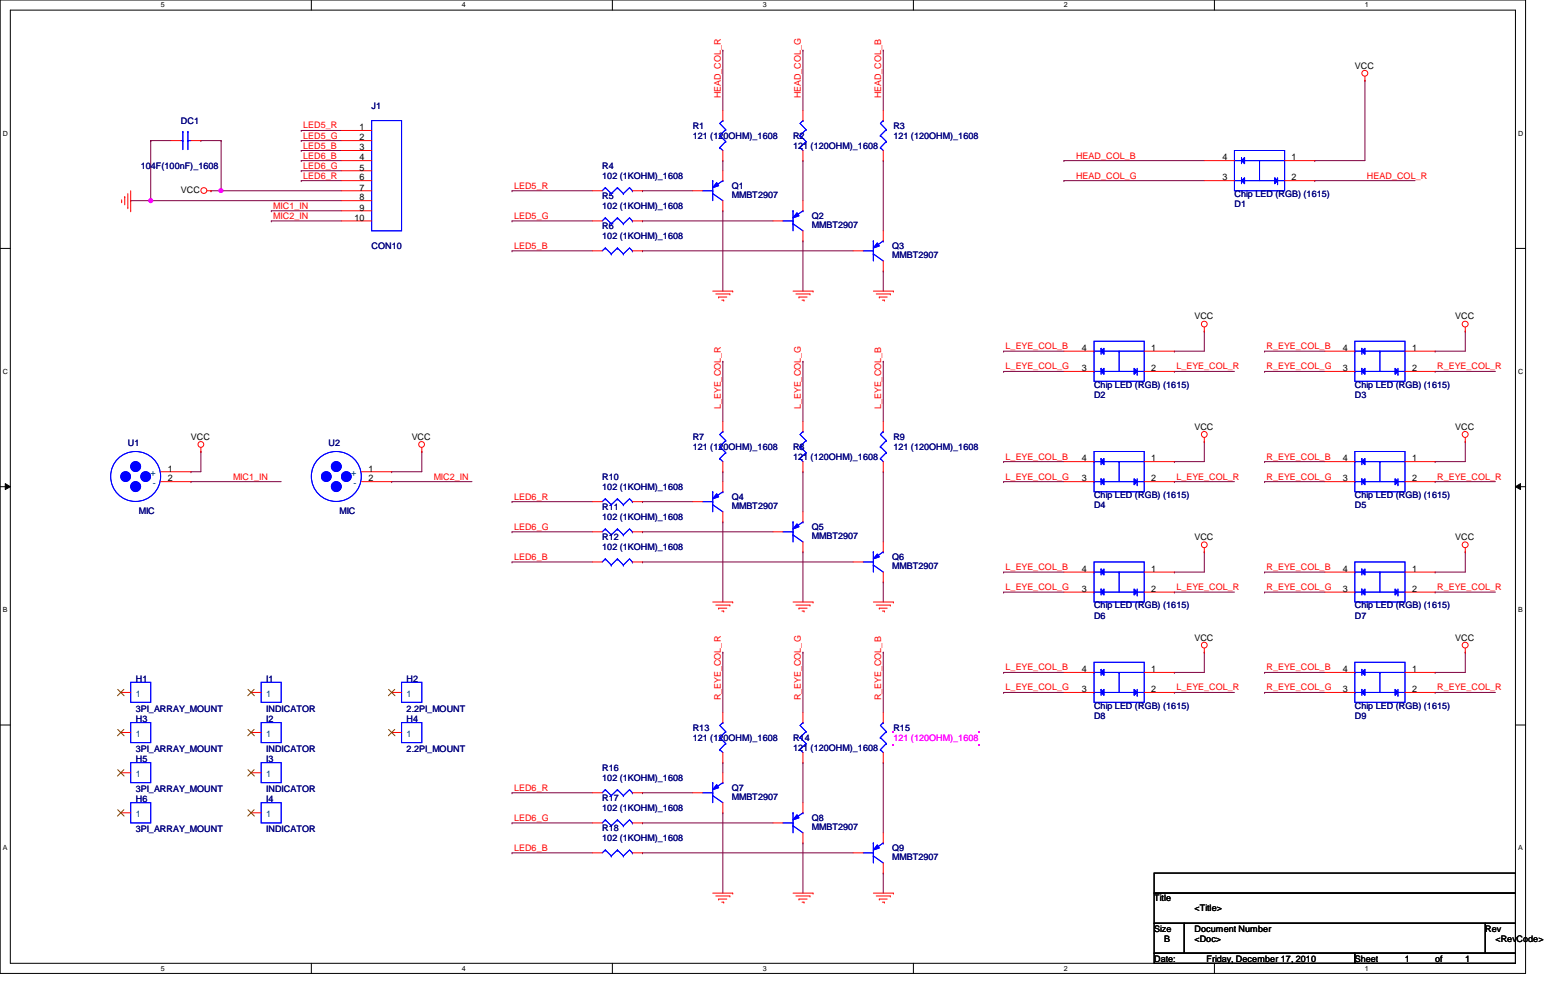
[picture p153: page 1]
