ROBOTIS-GIT/ROBOTIS-OP-Series-Data/ROBOTIS-OP, ROBOTIS-OP2/Hardware/Electronics/Boards/DARwIn-OP_Interface_rev3.pdf

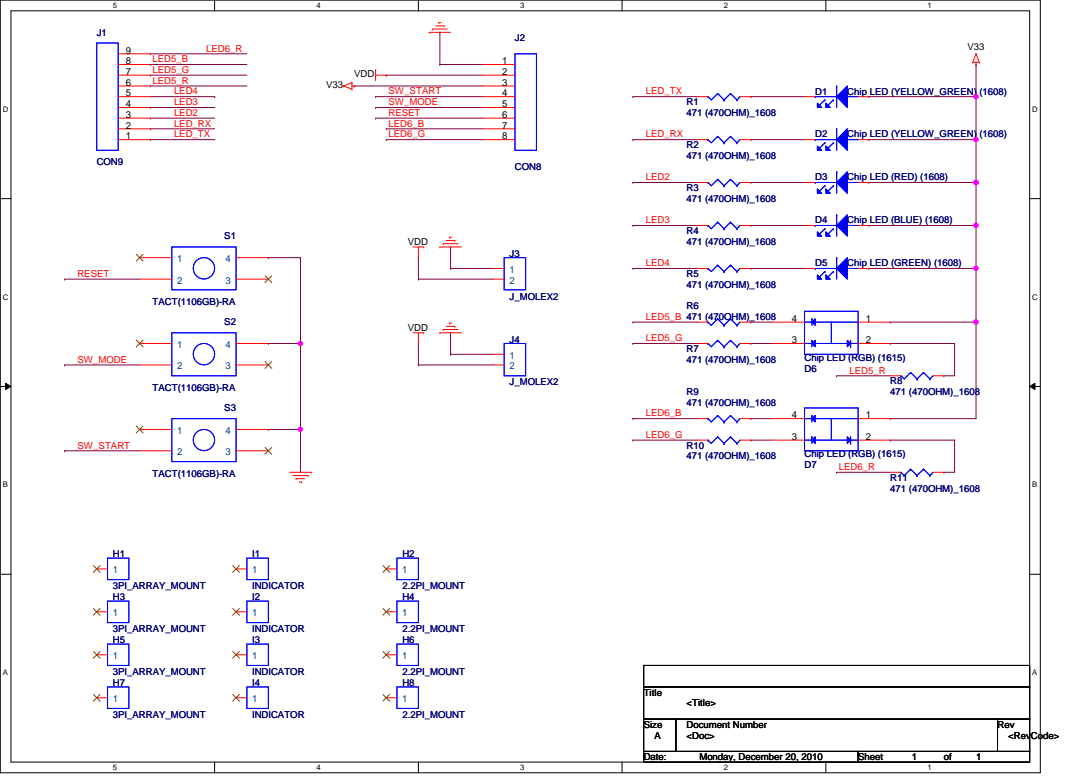
[picture p154: page 1]
