ROBOTIS-GIT/ROBOTIS-OP-Series-Data/ROBOTIS-OP, ROBOTIS-OP2/Hardware/Electronics/Boards/DARwIn-OP_Power.pdf

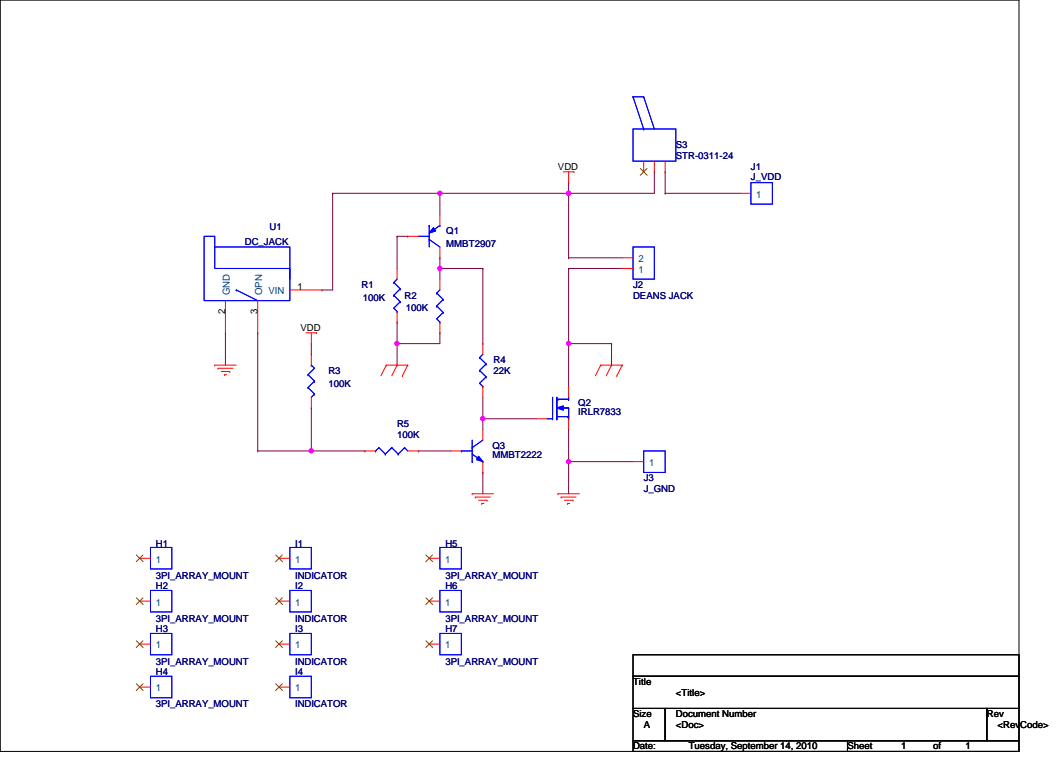
[picture p155: page 1]
