ROBOTIS-GIT/ROBOTIS-OP-Series-Data/ROBOTIS-OP, ROBOTIS-OP2/Hardware/Electronics/Optional Componenets/pr13_b01_bl.pdf

REV. | DESCRIPTION | CHK | DATE

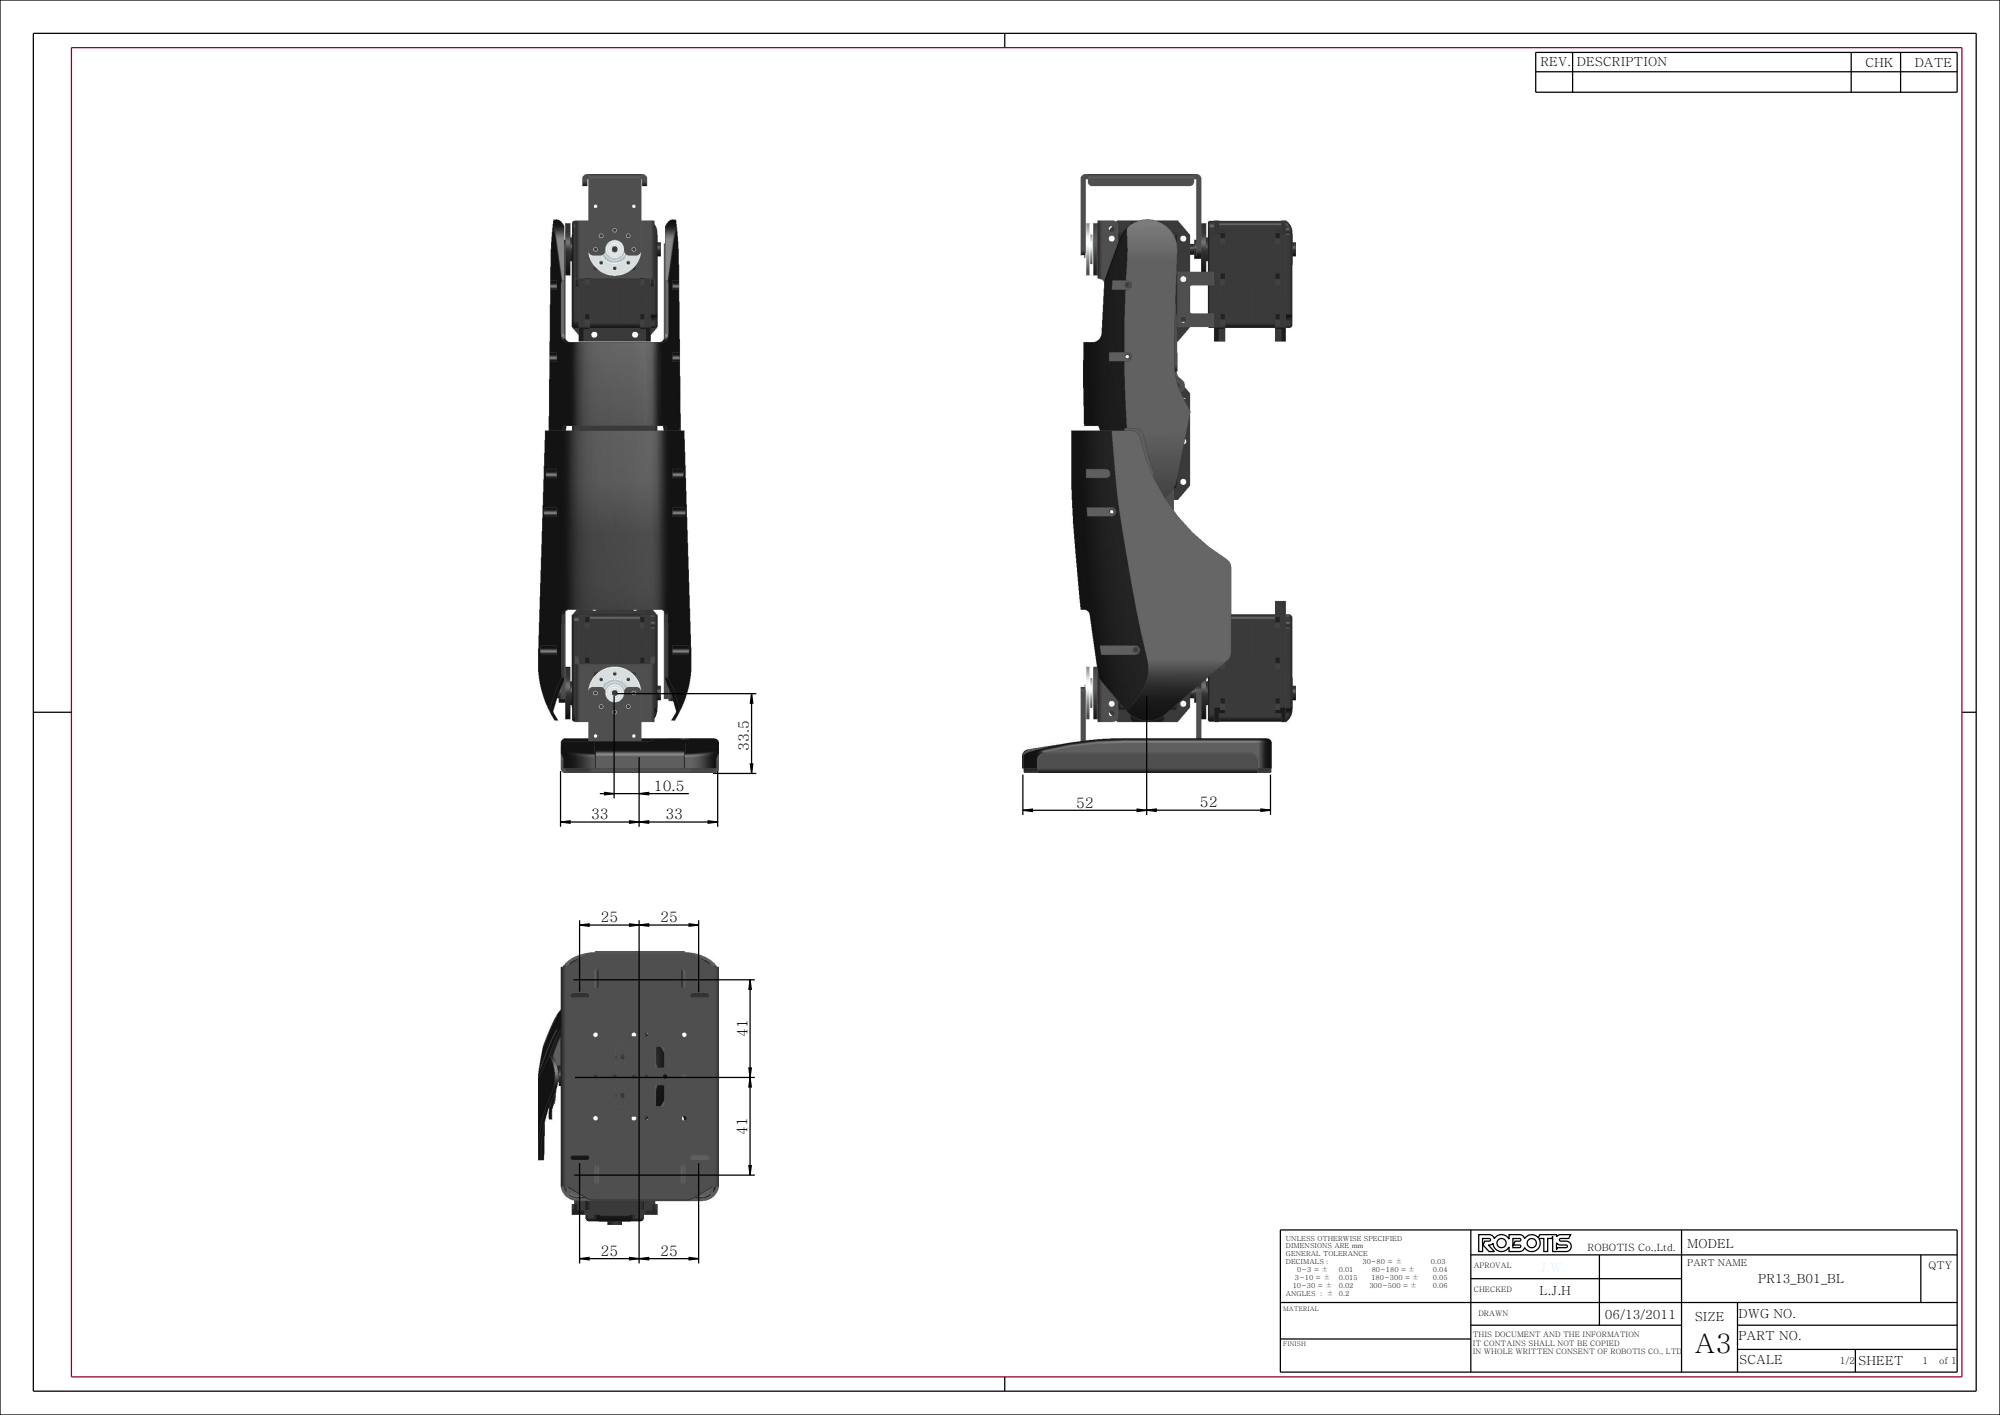
[picture p156: page 1]
FINISH

UNLESS OTHERWISE SPECIFIED DIMENSIONS ARE mm GENERAL TOLERANCE DECIMALS : 30-80 = ± 0.03 0-3 = ± 0.01 80-180 = ± 0.04 3-10 = ± 0.015 180-300 = ± 0.05 10-30 = ± 0.02 300-500 = ± 0.06 ANGLES : ± 0.2 | ROBOTIS Co.,Ltd. | MODEL

APROVAL J.W. | | PART NAME PR13_B01_BL | QTY

CHECKED L.J.H

MATERIAL | DRAWN | 06/13/2011 | SIZE A3 | DWG NO.

THIS DOCUMENT AND THE INFORMATION IT CONTAINS SHALL NOT BE COPIED IN WHOLE WRITTEN CONSENT OF ROBOTIS CO., LTD | | | PART NO.

SCALE 1/2 | SHEET 1 of 1
