ROBOTIS-GIT/ROBOTIS-OP-Series-Data/(commit log)

2017-07-24 - joined ROBOTIS-OP and ROBOTIS-OP2 directories - added ROBOTIS-OP3 files
    [ROBOTIS-OP3_cvr_arm_l_prt.stp, ROBOTIS-OP3_cvr_arm_u_prt.stp, ROBOTIS-OP3_cvr_body_b_prt.stp, ROBOTIS-OP3_cvr_body_f_prt.stp, ROBOTIS-OP3_cvr_foot_prt.stp, ROBOTIS-OP3_cvr_head_b_prt.stp, ROBOTIS-OP3_cvr_head_f_prt.stp, ROBOTIS-OP3_cvr_thigh_prt.stp]
2017-07-24 - skin file path changed.
    [ROBOTIS-OP3_cvr_arm_l_prt.stp, ROBOTIS-OP3_cvr_arm_u_prt.stp, ROBOTIS-OP3_cvr_body_b_prt.stp, ROBOTIS-OP3_cvr_body_f_prt.stp, ROBOTIS-OP3_cvr_foot_prt.stp, ROBOTIS-OP3_cvr_head_b_prt.stp, ROBOTIS-OP3_cvr_head_f_prt.stp, ROBOTIS-OP3_cvr_thigh_prt.stp]
2018-03-28 added schematic diagram of ROBOTIS-OP3
